jenosek/BP/measurements/spec5.png

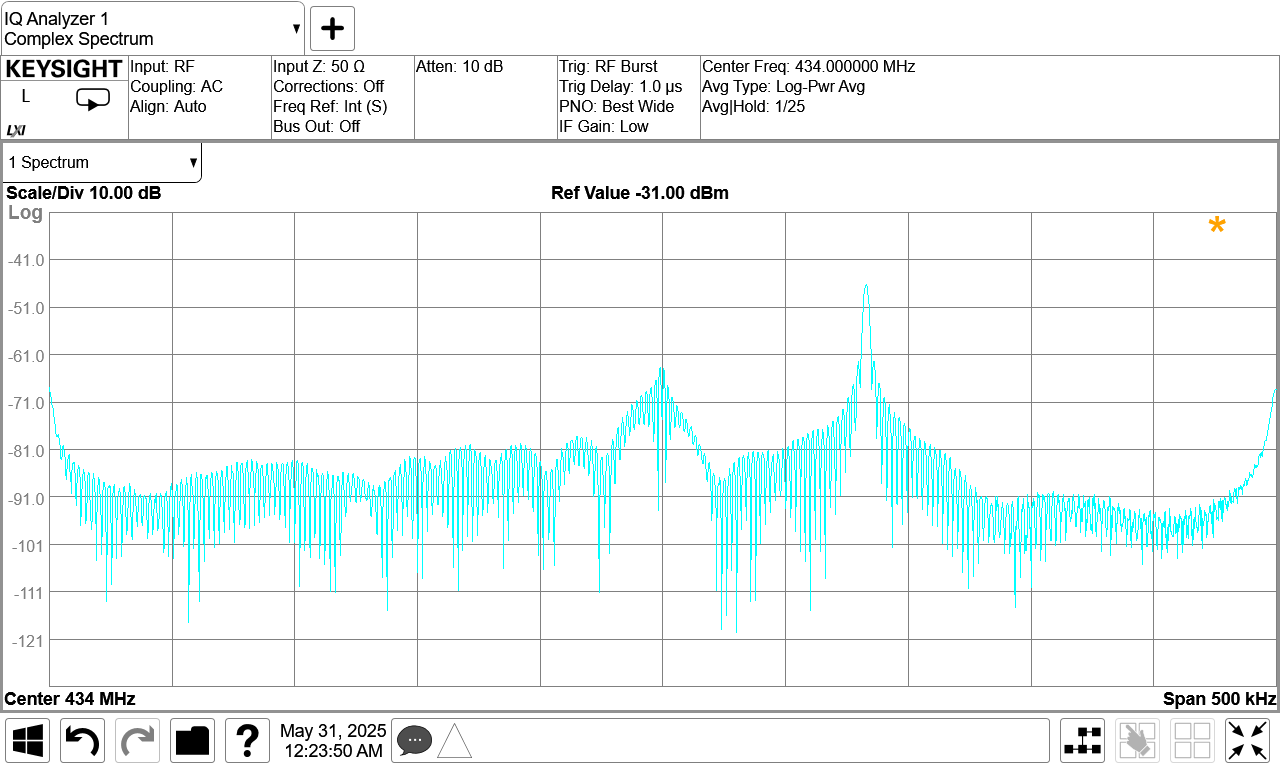
measurements/spec5.png
