jenosek/BP/measurements/spec25.png

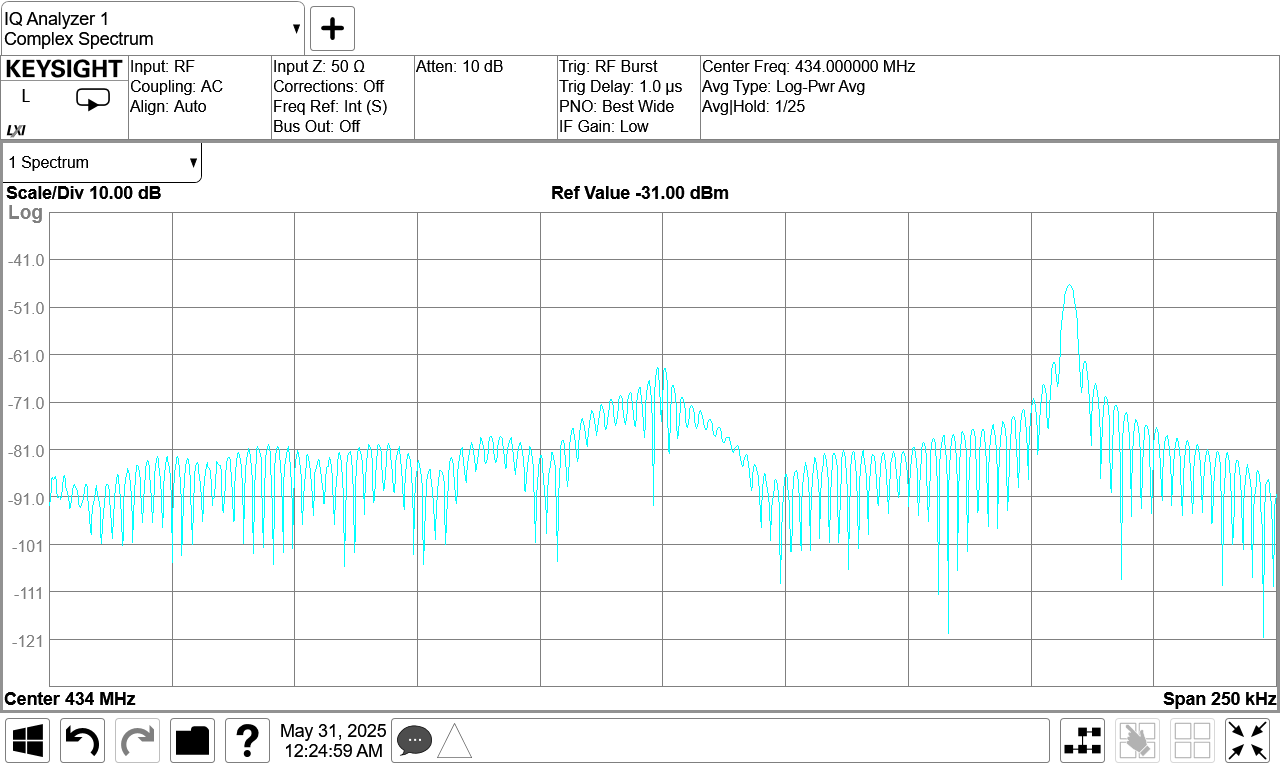
measurements/spec25.png
