jenosek/BP/measurements/specfm.png

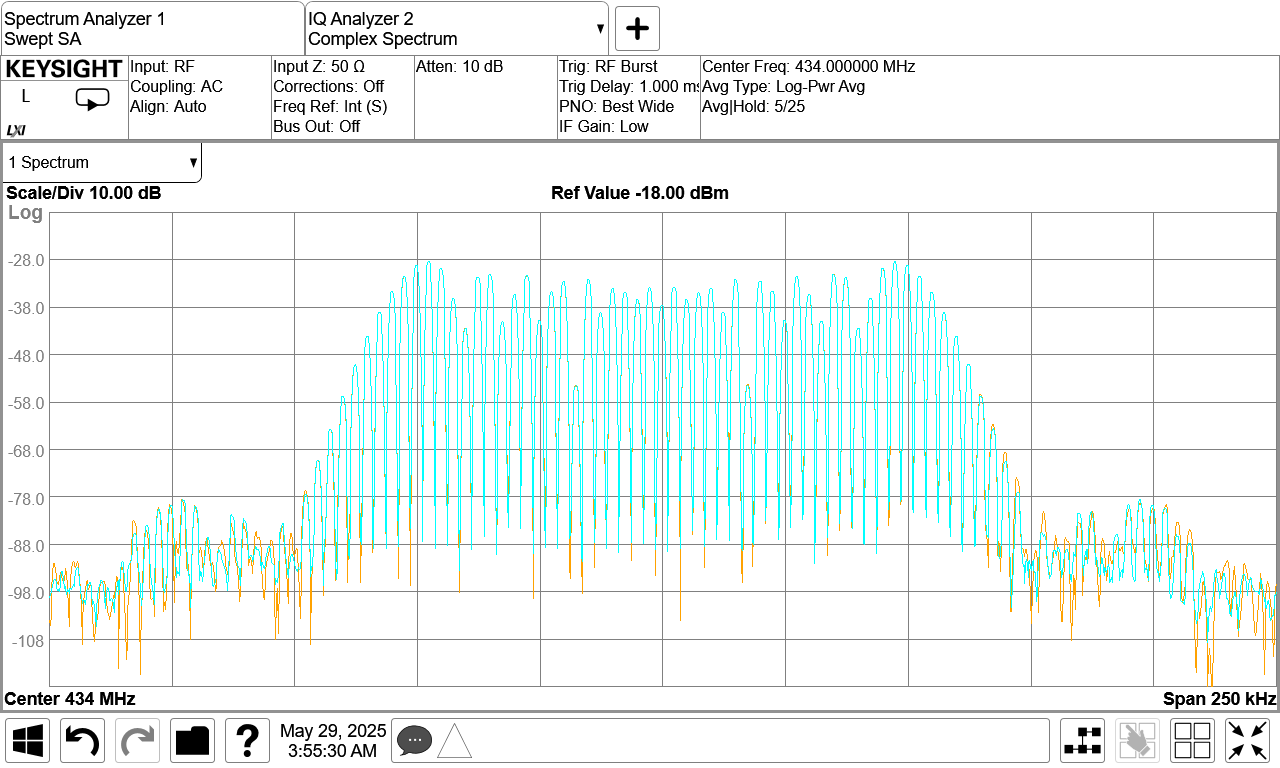
measurements/specfm.png
