jenosek/BP/measurements/ANT.PNG

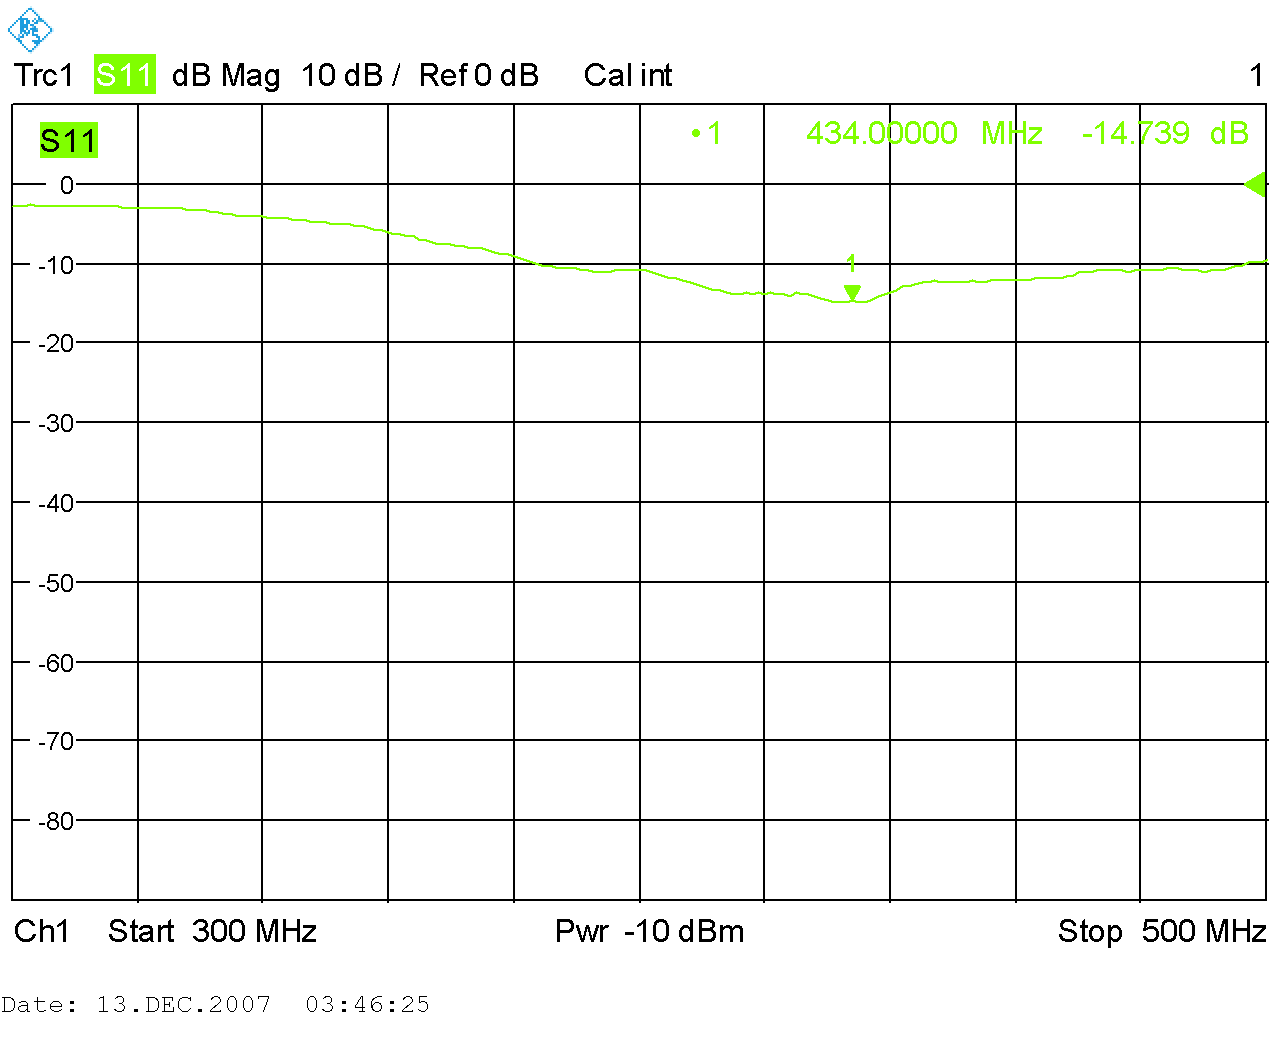
measurements/ANT.PNG
