jenosek/BP/measurements/zvlneni.png

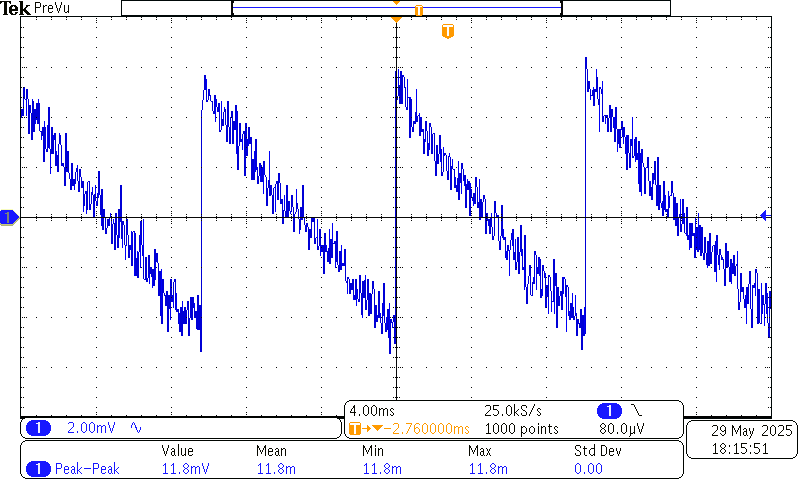
measurements/zvlneni.png
