jenosek/BP/hardware/PCBs/antenna/gerber/antenna-Edge_Cuts.pdf

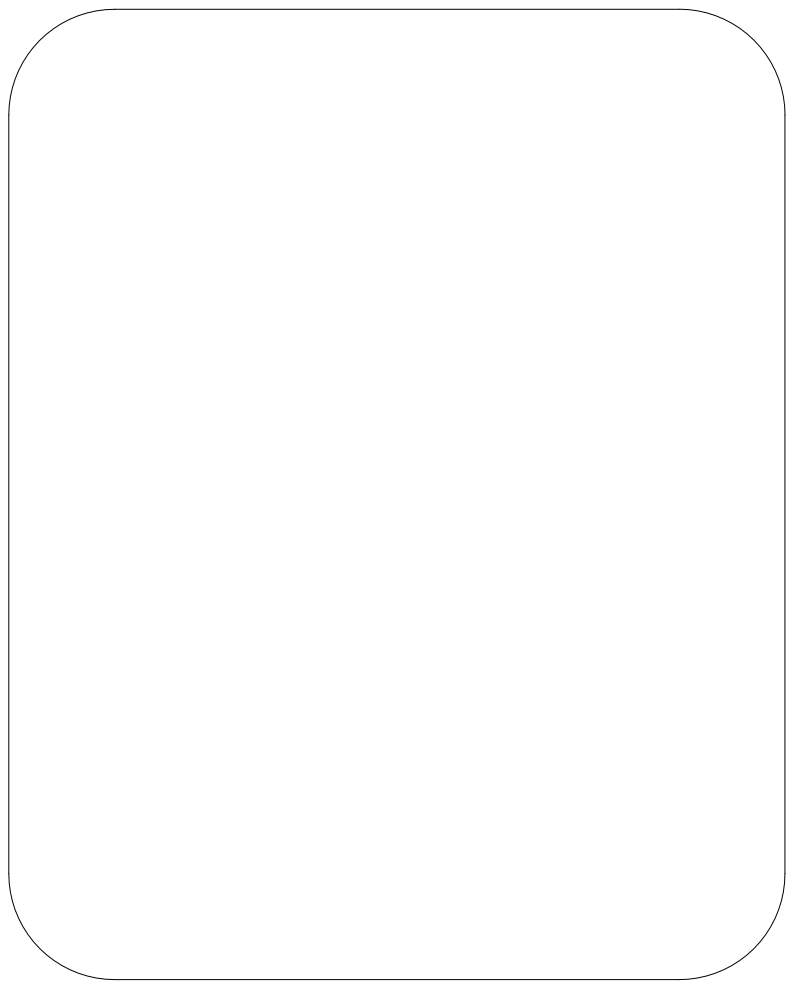
[picture p6: page 1]
