jenosek/BP/hardware/PCBs/antenna/gerber/antenna-F_Cu.pdf

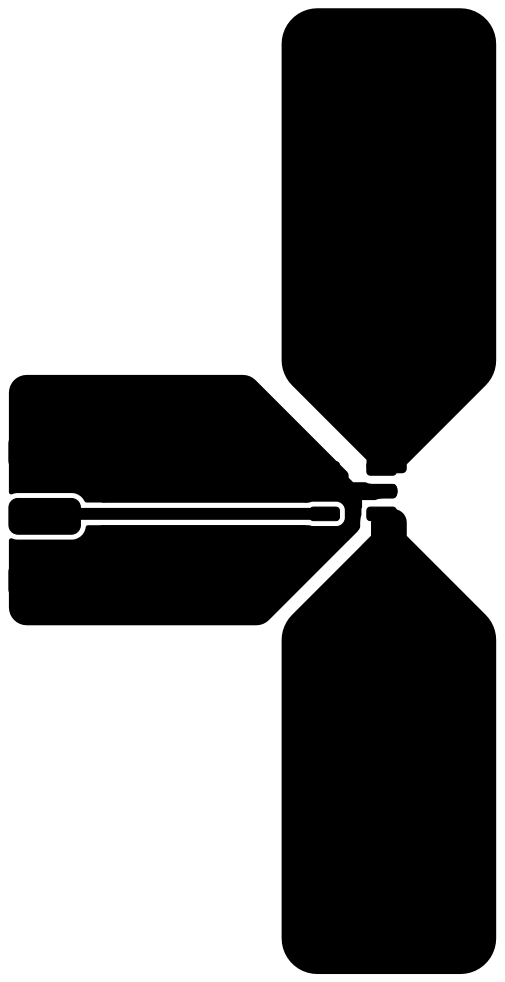
[picture p7: page 1]
