jenosek/BP/hardware/PCBs/antenna/gerber/antenna-F_Mask.pdf

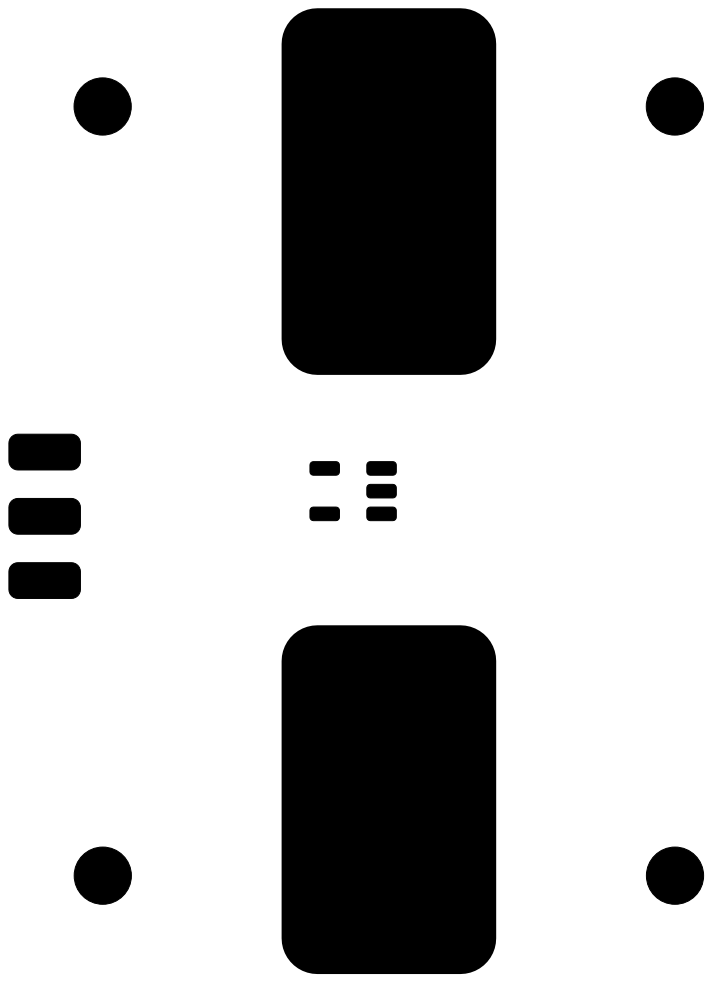
[picture p8: page 1]
