jenosek/BP/hardware/PCBs/antenna/gerber/antenna-F_Paste.pdf

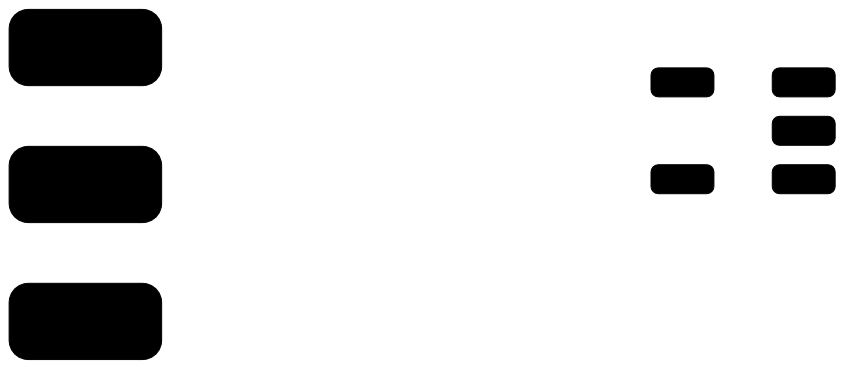
[picture p9: page 1]
