jenosek/BP/hardware/PCBs/antenna/gerber/antenna-F_Silkscreen.pdf

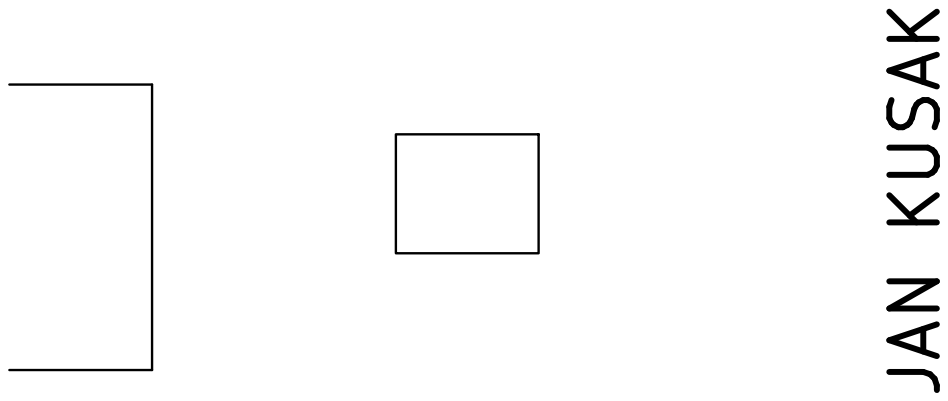
[picture p10: page 1]
