jenosek/BP/hardware/PCBs/antenna/gerber/pcb_Kusak.pdf

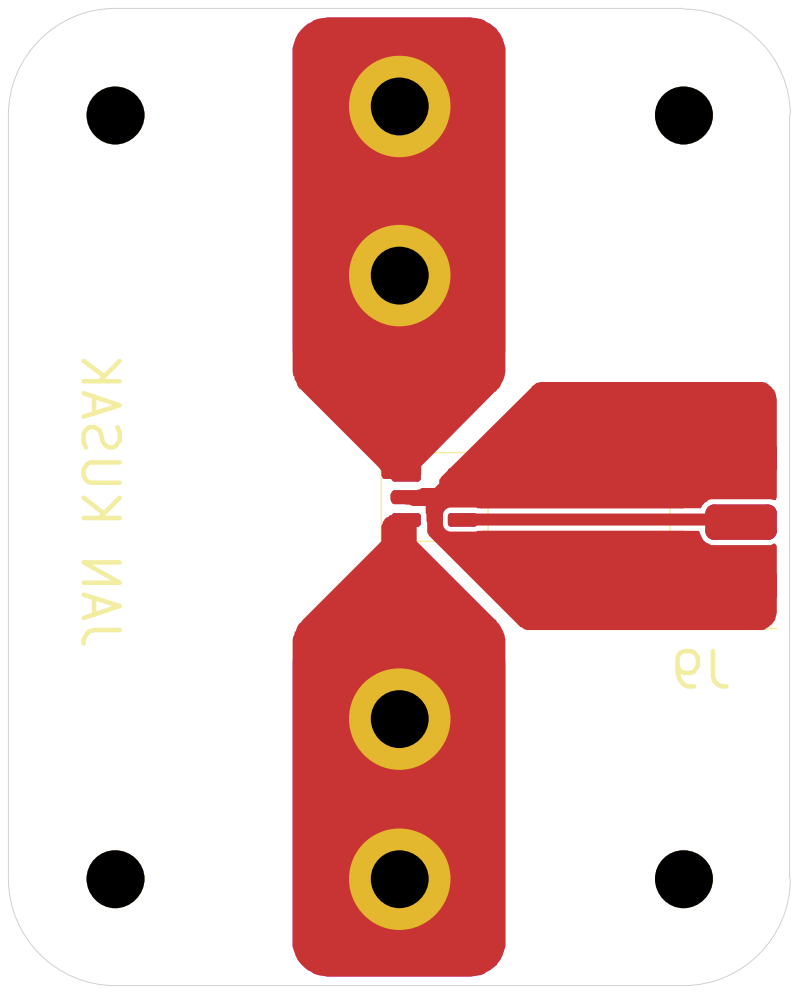
[picture p11: page 1]
