jenosek/BP/simulations/PSpice/tx_pa/tx_pa-PSpiceFiles/SCHEMATIC1/ac/ac.cir

** Profile: "SCHEMATIC1-ac"  [ C:\Skola\VUT\CubeSat\BP\simulations\PSpice\tx_pa\tx_pa-pspicefiles\schematic1\ac.sim ] 

** Creating circuit file "ac.cir" 
** WARNING: THIS AUTOMATICALLY GENERATED FILE MAY BE OVERWRITTEN BY SUBSEQUENT SIMULATIONS

*Libraries: 
* Profile Libraries :
* Local Libraries :
* From [PSPICE NETLIST] section of C:\Users\honza\AppData\Roaming\SPB_Data\cdssetup\OrCAD_PSpice\17.2.0\PSpice.ini file:
.lib "nomd.lib" 

*Analysis directives: 
.AC DEC 1400 100megHz 10GHz
.STEP LIN PARAM c 4pF 8pF 0.1pF 
.OPTIONS ADVCONV
.PROBE64 V(alias(*)) I(alias(*)) W(alias(*)) D(alias(*)) NOISE(alias(*)) 
.INC "..\SCHEMATIC1.net" 


.END
