jenosek/BP/simulations/PSpice/tx_pa/tx_pa-PSpiceFiles/SCHEMATIC1/test_cap/test_cap.cir

** Profile: "SCHEMATIC1-test_cap"  [ C:\Skola\VUT\CubeSat\BP\simulations\PSpice\tx_pa\tx_pa-pspicefiles\schematic1\test_cap.sim ] 

** Creating circuit file "test_cap.cir" 
** WARNING: THIS AUTOMATICALLY GENERATED FILE MAY BE OVERWRITTEN BY SUBSEQUENT SIMULATIONS

*Libraries: 
* Profile Libraries :
* Local Libraries :
* From [PSPICE NETLIST] section of C:\Users\honza\AppData\Roaming\SPB_Data\cdssetup\OrCAD_PSpice\17.2.0\PSpice.ini file:
.lib "nomd.lib" 

*Analysis directives: 
.AC DEC 1400 1megHz 10GHz
.OPTIONS ADVCONV
.PROBE64 V(alias(*)) I(alias(*)) W(alias(*)) D(alias(*)) NOISE(alias(*)) 
.INC "..\SCHEMATIC1.net" 


.END
