jenosek/BP/simulations/PSpice/ntc/ntc-PSpiceFiles/SCHEMATIC1/dc/dc.cir

** Profile: "SCHEMATIC1-dc"  [ c:\users\honza\desktop\bakalarka\sim\ntc\ntc-pspicefiles\schematic1\dc.sim ] 

** Creating circuit file "dc.cir" 
** WARNING: THIS AUTOMATICALLY GENERATED FILE MAY BE OVERWRITTEN BY SUBSEQUENT SIMULATIONS

*Libraries: 
* Profile Libraries :
* Local Libraries :
* From [PSPICE NETLIST] section of C:\Users\honza\AppData\Roaming\SPB_Data\cdssetup\OrCAD_PSpice\17.2.0\PSpice.ini file:
.lib "nomd.lib" 

*Analysis directives: 
.DC LIN PARAM T 273.15 323.15 1 
.OPTIONS ADVCONV
.PROBE64 V(alias(*)) I(alias(*)) W(alias(*)) D(alias(*)) NOISE(alias(*)) 
.INC "..\SCHEMATIC1.net" 


.END
