jenosek/BP/simulations/PSpice/ntc/ntc-PSpiceFiles/SCHEMATIC1/V_diff/V_diff.cir

** Profile: "SCHEMATIC1-V_diff"  [ c:\users\honza\desktop\bakalarka\sim\ntc\ntc-pspicefiles\schematic1\v_diff.sim ] 

** Creating circuit file "V_diff.cir" 
** WARNING: THIS AUTOMATICALLY GENERATED FILE MAY BE OVERWRITTEN BY SUBSEQUENT SIMULATIONS

*Libraries: 
* Profile Libraries :
* Local Libraries :
* From [PSPICE NETLIST] section of C:\Users\honza\AppData\Roaming\SPB_Data\cdssetup\OrCAD_PSpice\17.2.0\PSpice.ini file:
.lib "nomd.lib" 

*Analysis directives: 
.DC LIN PARAM T 298.15 318.15 1 
.STEP LIN PARAM R1 100 10k 100 
.OPTIONS ADVCONV
.PROBE64 V(alias(*)) I(alias(*)) W(alias(*)) D(alias(*)) NOISE(alias(*)) 
.INC "..\SCHEMATIC1.net" 


.END
