jenosek/BP/(list of files, drawings)

Other design files:
simulations/PSpice/lp_ant/LP_ANT.DSN
simulations/PSpice/lp_ant/lp_ant.opj
simulations/PSpice/ntc/NTC.DSN
simulations/PSpice/ntc/ntc.opj
simulations/PSpice/tx_pa/TX_PA.DSN
simulations/PSpice/tx_pa/tx_pa.opj
