jenosek/BP/hardware/PCBs/antenna/antenna.kicad_pcb

## KiCad design hardware/PCBs/antenna/antenna.kicad_pcb (2025-04-19)

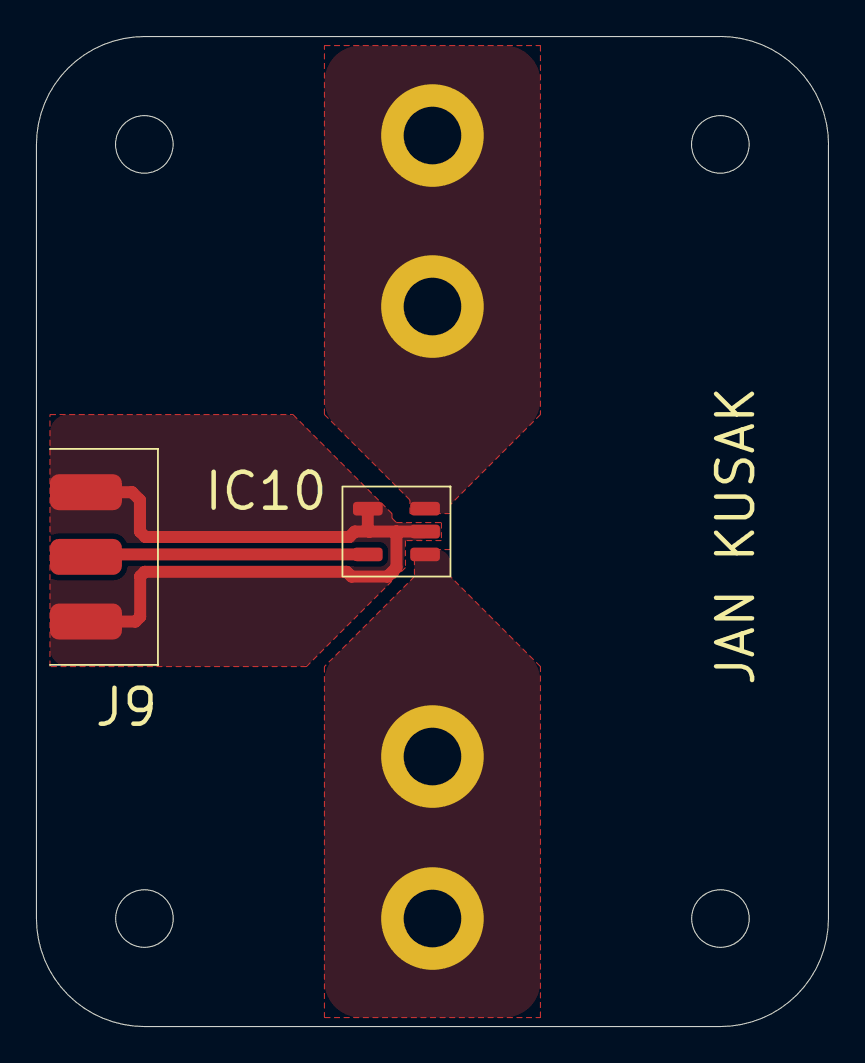
[picture p12: board antenna.kicad_pcb from above]

Board: 2 copper layers, 44.0 x 55.0 mm, 10 parts (0 on the bottom side), 4 nets.

Parts:
H, H5, H6, H8: MountingHole; MountingHole_3.2mm_M3
H1, H2, H3, H4: MountingHole_Pad; MountingHole_3.2mm_M3_ISO7380_Pad
IC10: C1.5-52T+
J9: sma_diagonal

Connections:
GND: IC10.2 (SECONDARY_CT), IC10.4 (PRIMARY), J9.1 (GND), J9.3 (GND)
unnamed: IC10.6 (PRIMARY_DOT), J9.2 (SIGNAL)
unnamed: H3.1, H4.1, IC10.3 (SECONDARY)
unnamed: H1.1, H2.1, IC10.1 (SECONDARY_DOT)
