jenosek/BP/hardware/PCBs/eps/eps.kicad_pcb

## KiCad design hardware/PCBs/eps/eps.kicad_pcb (2025-04-11)

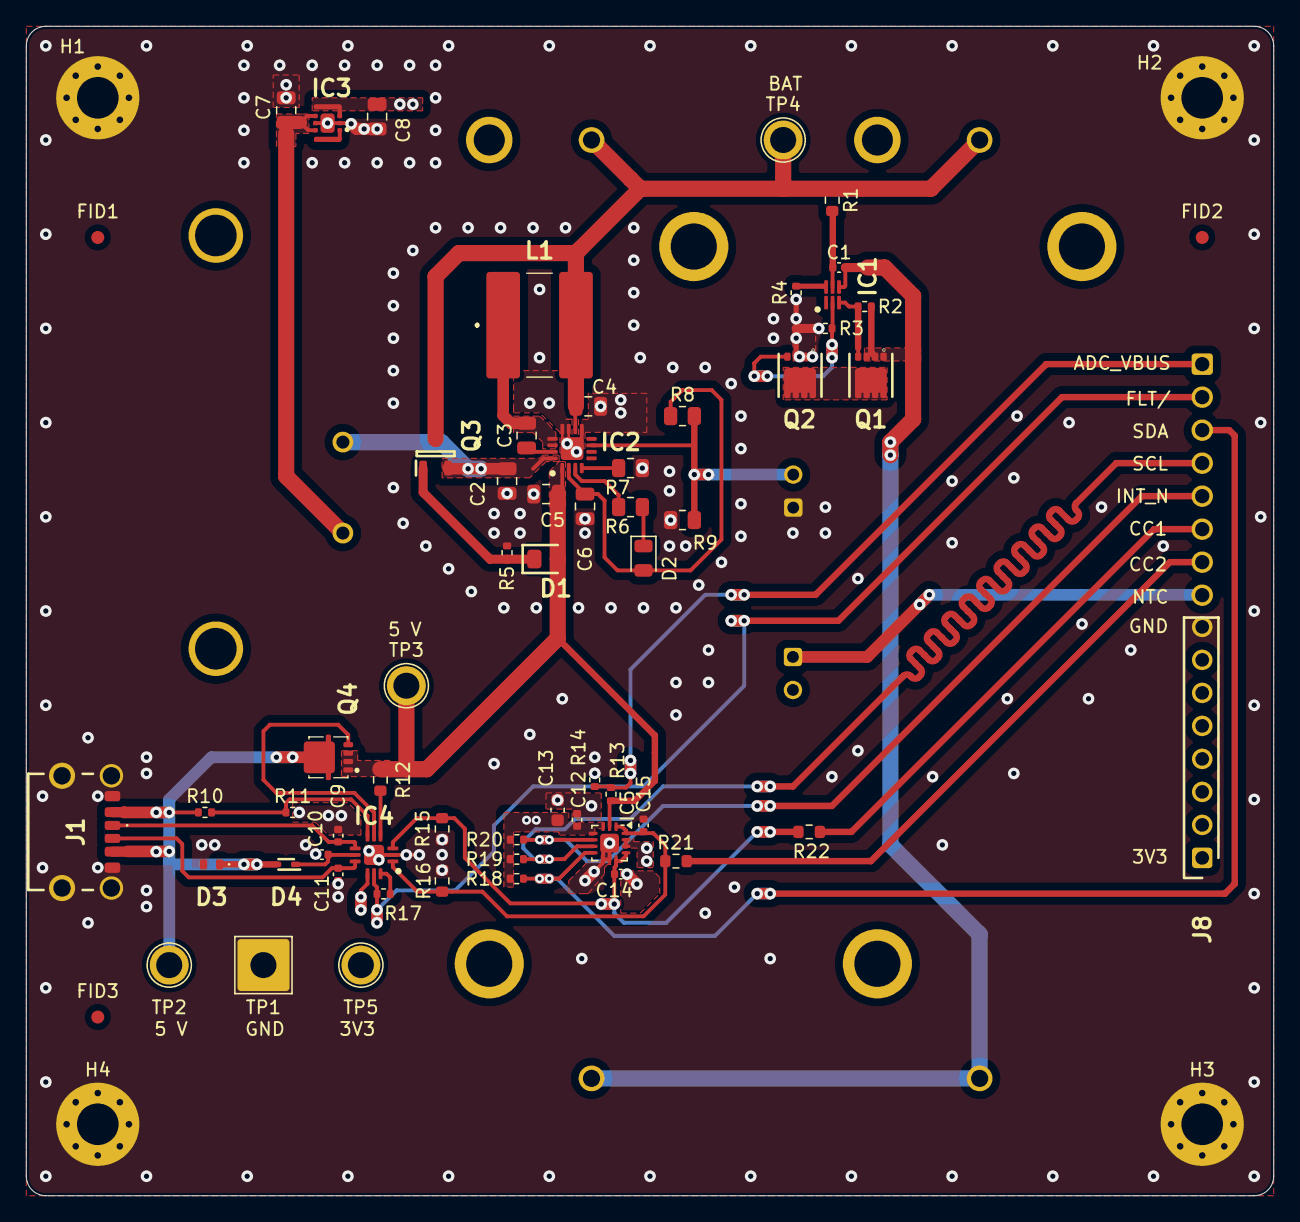
[picture p14: board eps.kicad_pcb from above]

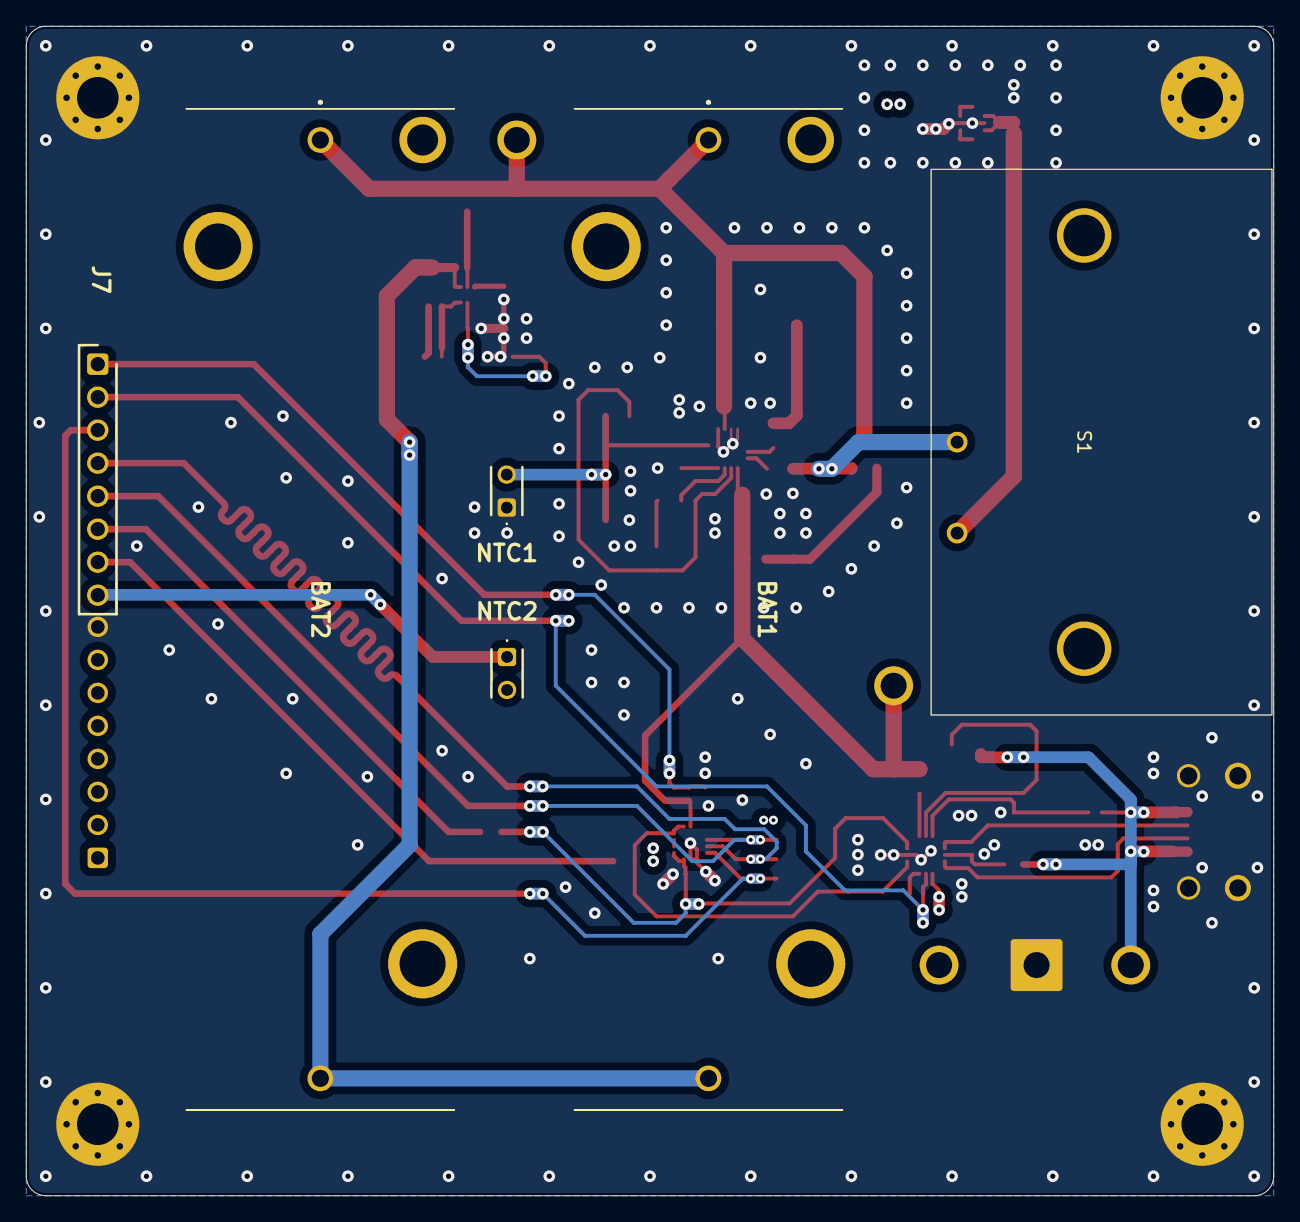
[picture p15: board eps.kicad_pcb from below]

Board: 4 copper layers, 96.0 x 90.0 mm, 71 parts (6 on the bottom side), 38 nets.

Parts:
BAT1, BAT2: 1043
C1, C10, C12: 100n; C_0402_1005Metric
C2, C4, C8: 10u; C_0805_2012Metric
C3: 47n; C_0805_2012Metric
C5, C6: 2u2; C_0805_2012Metric
C7: 4u7; C_0805_2012Metric
C9, C11, C14, C15: 330p; C_0402_1005Metric
C13: 1u; C_0603_1608Metric
D1: TS4148_RBG; DIOC2012X85N
D2: LED; LED_0805_2012Metric
D3: ESDA25P35-1U1M; ESDA25P351U1M
D4: BAT54KFILM; SODFL1608X70N
FID1, FID2, FID3: Fiducial; Fiducial_1mm_Mask2mm
H1, H2, H3, H4: MountingHole_Pad; MountingHole_3.2mm_M3_Pad_Via
IC1: BQ29732DSER; SON50P150X150X80-6N
IC2: BQ25302RTER; QFN50P300X300X80-17N-D
IC3: XCL240B333FR-G; XCL103D503CRG
IC4: TCPP01-M12; QFN50P300X300X100-13N-D
IC5: FUSB302BMPX; WQFN-14-1EP_2.5x2.5mm_P0.5mm_EP1.45x1.45mm
J1: UJC-H-G-SMT-2-P6-TR; UJCHGSMT2P6TR
J7: PH1-08-UA; HDRV8W64P0X254_1X8_2032X250X888P
J8: PRT-09279; RHDR8W87P0X254_1X8_2087X250X865P
L1: SRN8040-1R0Y; SRN80408R2Y
NTC1, NTC2: 103AT-2; 103AT2
Q1, Q2: CSD16406Q3; DQG_VSON-CLIP
Q3: DMP2305U-7; SOT96P240X115-3N
Q4: STL11N3LLH6; STL20N6F7
R1: 330; R_0603_1608Metric
R2, R3: 4M99; R_0402_1005Metric
R4: 2k2; R_0402_1005Metric
R5: 100k; R_0402_1005Metric
R6: 150; R_0805_2012Metric
R7: 20k; R_0805_2012Metric
R8: 4k53; R_0805_2012Metric
R9: 23k2; R_0805_2012Metric
R10, R17: 10k; R_0402_1005Metric
R11: 2k4; R_0402_1005Metric
R12, R21, R22: 0R; R_0603_1608Metric
R13: 1k69; R_0402_1005Metric
R14: 3k3; R_0402_1005Metric
R15, R16: 5k1; R_0603_1608Metric
R18, R19, R20: 4k7; R_0402_1005Metric
S1: RA12131100
TP1: TestPoint; TestPoint_THTPad_4.0x4.0mm_Drill2.0mm
TP2, TP3, TP4, TP5: TestPoint; TestPoint_Plated_Hole_D2.0mm

Connections:
+3V3: C8.1, C12.1, C13.1, IC3.3 (VOUT), IC3.8 (L2), IC4.10 (DB/), IC4.12 (VCC), IC5.3 (VDD), IC5.4 (VDD), IC5.12 (VCONN), IC5.13 (VCONN), J8.1, NTC2.2, R17.2, R18.1, R19.1, R20.1, TP5.1
/ADC_VBUS_PS: J7.1, R13.2, R14.1
/BYPASS_CC1_PS: J7.6, R22.2
/BYPASS_CC2_PS: J7.7, R21.2
/FLT/_PS: IC4.11 (FLT/), J7.2, R17.1
/INT_N_PS: IC5.5 (INT_N), J7.5, R20.2
/NTC_2_PS: J7.8, NTC2.1
/USB_CC1: C14.1, IC4.3 (CC1), IC5.10 (CC1), IC5.11 (CC1), R15.1, R22.1
/USB_CC2: C15.1, IC4.1 (CC2), IC5.1 (CC2), IC5.14 (CC2), R16.1, R21.1
/USB_SCL_PS: IC5.6 (SCL), J7.4, R19.2
/USB_SDA_PS: IC5.7 (SDA), J7.3, R18.2
/VBUS: C5.1, D1.2 (A), IC2.1 (VBUS), IC5.2 (VBUS), Q4.1 (S_1), Q4.2 (S_2), Q4.3 (S_3), R12.1, R13.1, TP3.1
GND: C2.2, C4.2, C5.2, C6.2, C7.2, C8.2, C9.1, C10.2, C11.2, C12.2, C13.2, C14.2, C15.2, D3.2 (A), H1.1, H2.1, H3.1, H4.1, IC2.9 (VSET), IC2.11 (GND_1), IC2.12 (GND_2), IC2.17 (EP), IC3.2 (AGND), IC3.5 (PGND), IC3.9 (EP), IC4.2 (GND), IC4.13 (EP), IC5.8 (GND), IC5.9 (GND), IC5.15 (GND), J1.1 (MH1), J1.2 (MH2), J1.3 (MH3), J1.4 (MH4), J1.A12 (GND_1), J1.B12 (GND_2), J8.8, NTC1.1, Q2.1 (S_1), Q2.2 (S_2), Q2.3 (S_3), R3.2, R4.2, R5.2, R7.2, R9.2, R11.2, R14.2, R15.2, R16.2, TP1.1
unnamed: BAT1.1 (+), BAT2.1 (+), C4.1, IC2.10 (BAT), L1.2, Q3.3 (D), R1.1, TP4.1
unnamed: BAT1.2 (-), BAT2.2 (-), C1.2, IC1.4 (VSS), Q1.1 (S_1), Q1.2 (S_2), Q1.3 (S_3), R2.2
unnamed: D1.1 (K), Q3.1 (G), R5.1
unnamed: C6.1, D2.2 (A), IC2.2 (REGN), R8.1
unnamed: D2.1 (K), R6.2
unnamed: D3.1 (K), D4.2 (A), J1.A9 (VBUS_1), J1.B9 (VBUS_2), Q4.5 (D), R10.1, TP2.1
unnamed: C10.1, D4.1 (K), IC4.8 (IN_GD)
unnamed: C1.1, IC1.5 (BAT), R1.2
unnamed: IC1.2 (COUT), Q2.4 (G), R3.1
unnamed: IC1.3 (DOUT), Q1.4 (G), R2.1
unnamed: IC1.6 (V-), R4.1
unnamed: C3.1, IC2.15 (BTST)
unnamed: IC2.4 (ICHG), R7.1
unnamed: C2.1, IC2.16 (PMID), Q3.2 (S), S1.1
unnamed: IC2.3 (STAT), R6.1
unnamed: C3.2, IC2.13 (SW_1), IC2.14 (SW_2), L1.1
unnamed: IC2.7 (TS), NTC1.2, R8.2, R9.1
unnamed: C7.1, IC3.4 (EN), IC3.6 (VIN), S1.2
unnamed: IC3.1 (LX), IC3.7 (L1)
unnamed: C9.2, IC4.7 (CC1C), J1.A5 (CC1)
unnamed: C11.1, IC4.9 (CC2C), J1.B5 (CC2)
unnamed: IC4.5 (GATE), Q4.4 (G)
unnamed: IC4.4 (SOURCE), R12.2
unnamed: IC4.6 (VBUS_CTRL), R10.2, R11.1
unnamed: Q1.5 (D_1), Q1.6 (D_2), Q1.7 (D_3), Q1.8 (D_4), Q1.9, Q2.5 (D_1), Q2.6 (D_2), Q2.7 (D_3), Q2.8 (D_4), Q2.9
