jenosek/BP/hardware/PCBs/mcu/mcu.kicad_pcb

## KiCad design hardware/PCBs/mcu/mcu.kicad_pcb (2025-04-11)

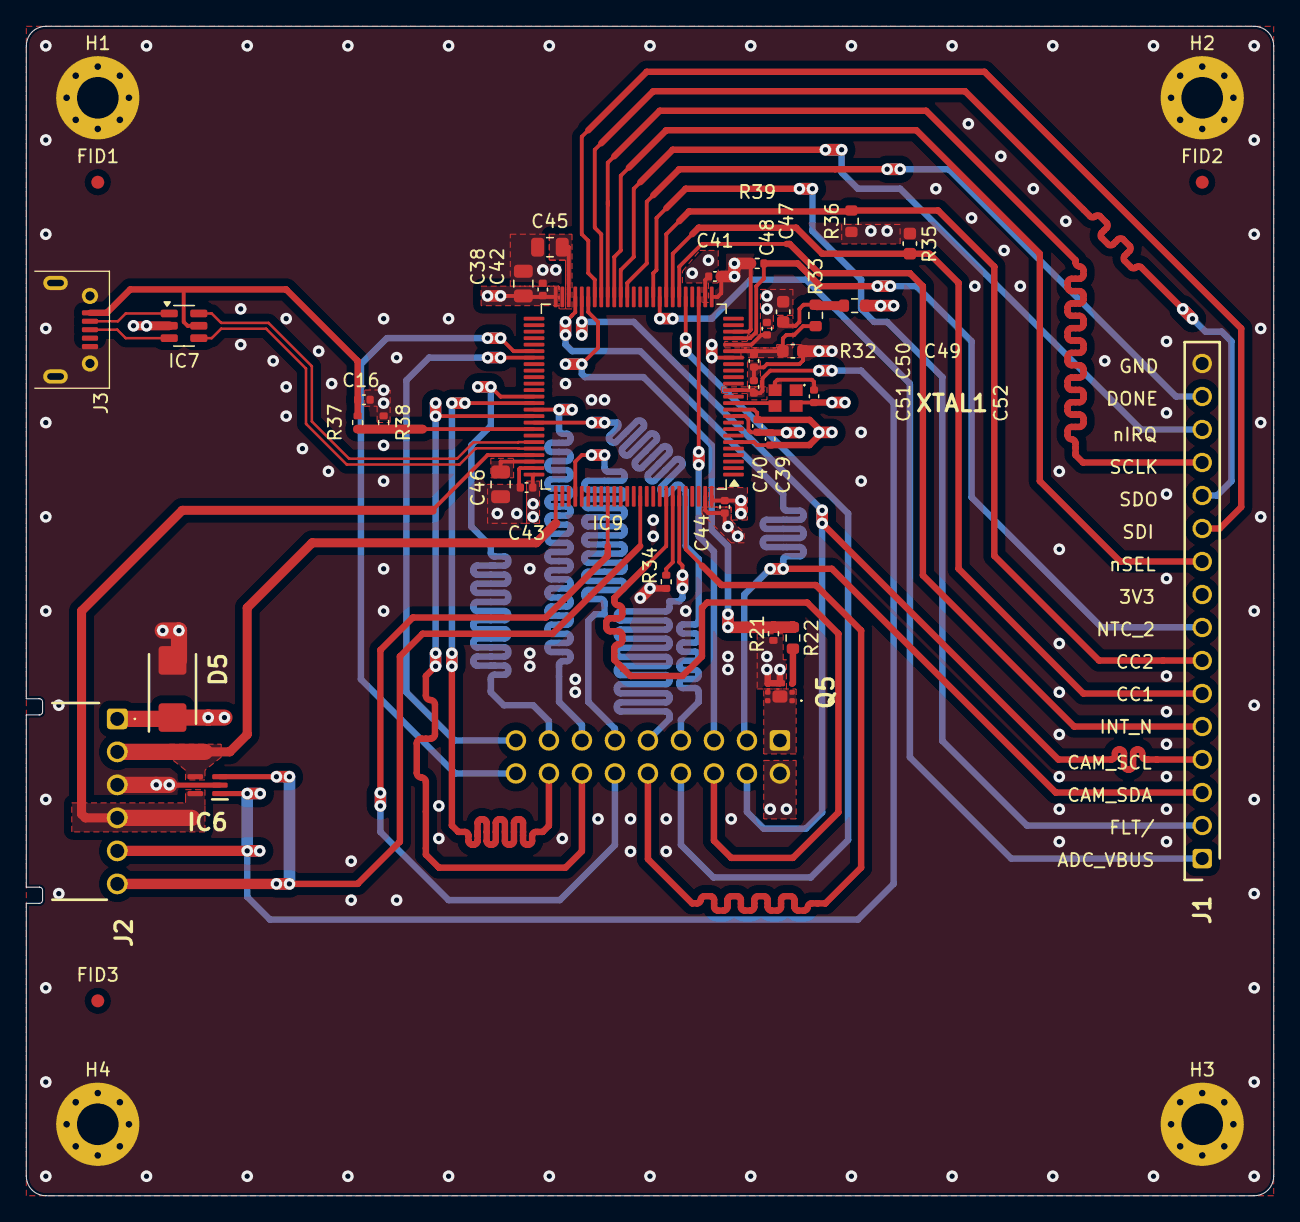
[picture p16: board mcu.kicad_pcb from above]

Board: 4 copper layers, 96.0 x 90.0 mm, 43 parts (1 on the bottom side), 49 nets.

Parts:
C16, C39, C40, C41, C42, C43, C44, C48, C50, C51: 100n; C_0402_1005Metric
C38: 4u7; C_0805_2012Metric
C45, C46: 2u2; C_0805_2012Metric
C47, C49: 1u; C_0603_1608Metric
C52: 10n; C_0402_1005Metric
D5: SMLVT3V3; DIOM5436X265N
FID1, FID2, FID3: Fiducial; Fiducial_1mm_Mask2mm
H1, H2, H3, H4: MountingHole_Pad; MountingHole_3.2mm_M3_Pad_Via
IC6: ESDALC6V1W5; SOT65P210X110-5N
IC7: USBLC6-2SC6; SOT-23-6
IC9: STM32H7A3VIT6; LQFP-100_14x14mm_P0.5mm
J1: 61301611821; RHDR16W82P0X254_1X16_4114X250X865P
J2: 22-16-2060; 22162060
J3: MCR-B-S-RA-SMT-CS5A-NF-TR
J4: RS2-18-G; RHDR18W60P254_2X9_2337X500X889P
Q5: DMN1008UFDF-7; DMN1008UFDF7
R21: 100k; R_0402_1005Metric
R22: 169; R_0603_1608Metric
R32, R33, R36: 0R; R_0603_1608Metric
R34, R39: 10k; R_0402_1005Metric
R35: 0R; C_0603_1608Metric
R37: 1k69; R_0402_1005Metric
R38: 3k3; R_0402_1005Metric
XTAL1: ASDDV-8.000MHZ-LR-T; AbraconASDDV

Connections:
+3V3: C38.1, C39.1, C40.1, C41.1, C42.1, C43.1, C44.1, C52.1, D5.1 (K), IC9.6 (VBAT), IC9.11 (VDD), IC9.27 (VDD), IC9.50 (VDD), IC9.75 (VDD), IC9.100 (VDD), J1.9, J2.1, J4.2, R32.1, XTAL1.4 (VDD)
/3V3: J4.1, Q5.1 (DRAIN_1), Q5.2 (DRAIN_2), Q5.5 (DRAIN_3), Q5.6 (DRAIN_4), Q5.7 (DRAIN_5)
/ADC_VBUS: IC9.34 (PB0), J1.1
/BOOT: IC9.94 (BOOT0), R34.2
/CAM_3V3: IC9.45 (PE15), R21.1, R22.1
/CAM_SCL: IC9.46 (PB10), J1.4, J4.4
/CAM_SDA: IC9.47 (PB11), J1.3, J4.3
/CC1: IC9.32 (PC4), J1.6, R35.1
/CC2: IC9.33 (PC5), J1.7, R36.1
/COMMAND_DONE: IC9.39 (PE9), J1.15
/D0: IC9.63 (PC6), J4.15
/D1: IC9.64 (PC7), J4.16
/D2: IC9.65 (PC8), J4.13
/D3: IC9.66 (PC9), J4.14
/D4: IC9.79 (PC11), J4.11
/D5: IC9.84 (PD3), J4.12
/D6: IC9.95 (PB8), J4.9
/D7: IC9.96 (PB9), J4.10
/FLT/: IC9.35 (PB1), J1.2
/HS: IC9.28 (PA4), J4.5
/INT_N: IC9.31 (PA7), J1.5
/MCLK: IC9.67 (PA8), J4.7
/NRST: C51.1, IC6.1 (I/01), IC9.14 (NRST), J2.5
/NTC_2+: IC9.22 (PA0), J1.8, R39.2
/PCLK: IC9.30 (PA6), J4.8
/PWDN: IC9.57 (PD10), J4.17
/RCC_OSC_IN: IC9.12 (PH0), XTAL1.3 (OUTPUT)
/RST: IC9.56 (PD9), J4.18
/SCLK: IC9.42 (PE12), J1.13
/SDI: IC9.44 (PE14), J1.11
/SDO: IC9.43 (PE13), J1.12
/SWCLK: IC6.4 (I/03), IC9.76 (PA14), J2.2
/SWDIO: IC6.5 (I/04), IC9.72 (PA13), J2.4
/TRACE: IC6.3 (I/02), IC9.89 (PB3), J2.6
/USB_OTG_HS_D+: IC7.4 (I/O2), IC9.71 (PA12)
/USB_OTG_HS_D-: IC7.6 (I/O1), IC9.70 (PA11)
/USB_OTG_HS_VBUS: C16.2, IC7.5 (VBUS), J3.1 (VBUS), R37.1
/USB_VBUS: IC9.68 (PA9), R37.2, R38.1
/VCAP1: C45.1, IC9.48 (VCAP)
/VCAP2: C46.1, IC9.73 (VCAP)
/VDDA: C47.1, C48.1, IC9.21 (VDDA), R32.2, R33.2
/VREF+: C49.1, C50.1, IC9.20 (VREF+), R33.1
/VS: IC9.93 (PB7), J4.6
/nIRQ: IC9.40 (PE10), J1.14
/nSEL: IC9.41 (PE11), J1.10
GND: C16.1, C38.2, C39.2, C40.2, C41.2, C42.2, C43.2, C44.2, C45.2, C46.2, C47.2, C48.2, C49.2, C50.2, C51.2, C52.2, D5.2 (A), H1.1, H2.1, H3.1, H4.1, IC6.2 (GND), IC7.2 (GND), IC9.10 (VSS), IC9.19 (VSSA), IC9.23 (PA1), IC9.26 (VSS), IC9.49 (VSS), IC9.74 (VSS), IC9.99 (VSS), J1.16, J2.3, J3.5 (GND), J3.6 (Shield), Q5.4 (SOURCE_1), Q5.8 (SOURCE_2), R21.2, R34.1, R35.2, R36.2, R38.2, R39.1, XTAL1.2 (GND)
unnamed: IC7.3 (I/O2), J3.3 (D+)
unnamed: IC7.1 (I/O1), J3.2 (D-)
unnamed: Q5.3 (GATE), R22.2
