jenosek/BP/hardware/schematics/Charger-PowerManagement.kicad_sch

## KiCad design hardware/schematics/Charger-PowerManagement.kicad_sch (2025-02-28)

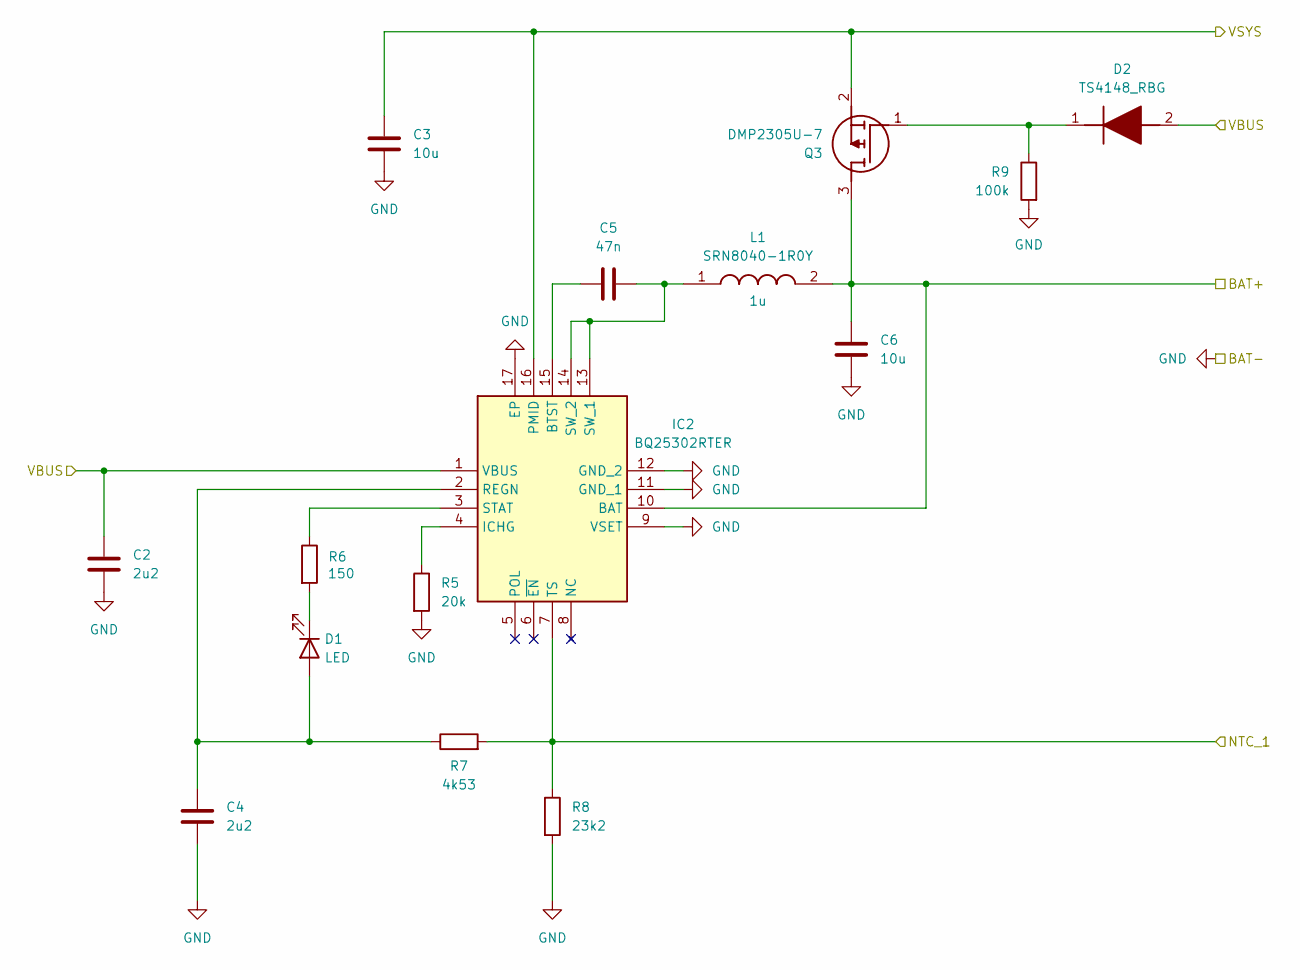
[picture p17: schematic Charger-PowerManagement.kicad_sch]

Parts:
C2, C4: 2u2; C_0805_2012Metric
C3, C6: 10u; C_0805_2012Metric
C5: 47n; C_0805_2012Metric
D1: LED; LED_0805_2012Metric
D2: TS4148_RBG; DIOC2012X85N; Manufacturer_Part_Number TS4148 RBG; Mouser Part Number 821-TS4148RBG
IC2: BQ25302RTER; QFN50P300X300X80-17N-D; Manufacturer_Part_Number BQ25302RTER; Mouser Part Number 595-BQ25302RTER
L1: SRN8040-1R0Y; SRN80408R2Y; Manufacturer_Part_Number SRN8040-1R0Y; Mouser Part Number 652-SRN8040-1R0Y
Q3: DMP2305U-7; SOT96P240X115-3N; Manufacturer_Part_Number DMP2305U-7; Mouser Part Number 621-DMP2305U-7
R5: 20k; R_0805_2012Metric
R6: 150; R_0805_2012Metric
R7: 4k53; R_0805_2012Metric
R8: 23k2; R_0805_2012Metric
R9: 100k

Connections:
BAT+: C6.1, IC2.10 (BAT), L1.2, Q3.3 (D)
GND: C2.2, C3.2, C4.2, C6.2, IC2.9 (VSET), IC2.11 (GND_1), IC2.12 (GND_2), IC2.17 (EP), R5.2, R8.2, R9.2
NTC_1: IC2.7 (TS), R7.2, R8.1
unnamed: C4.1, D1.2 (A), IC2.2 (REGN), R7.1
unnamed: C5.1, IC2.15 (BTST)
unnamed: C5.2, IC2.13 (SW_1), IC2.14 (SW_2), L1.1
unnamed: D1.1 (K), R6.2
unnamed: D2.1 (K), Q3.1 (G), R9.1
unnamed: IC2.3 (STAT), R6.1
unnamed: IC2.4 (ICHG), R5.1
VBUS: C2.1, D2.2 (A), IC2.1 (VBUS)
VSYS: C3.1, IC2.16 (PMID), Q3.2 (S)
