jenosek/BP/hardware/schematics/Power_Management.kicad_sch

## KiCad design hardware/schematics/Power_Management.kicad_sch (2025-03-09)

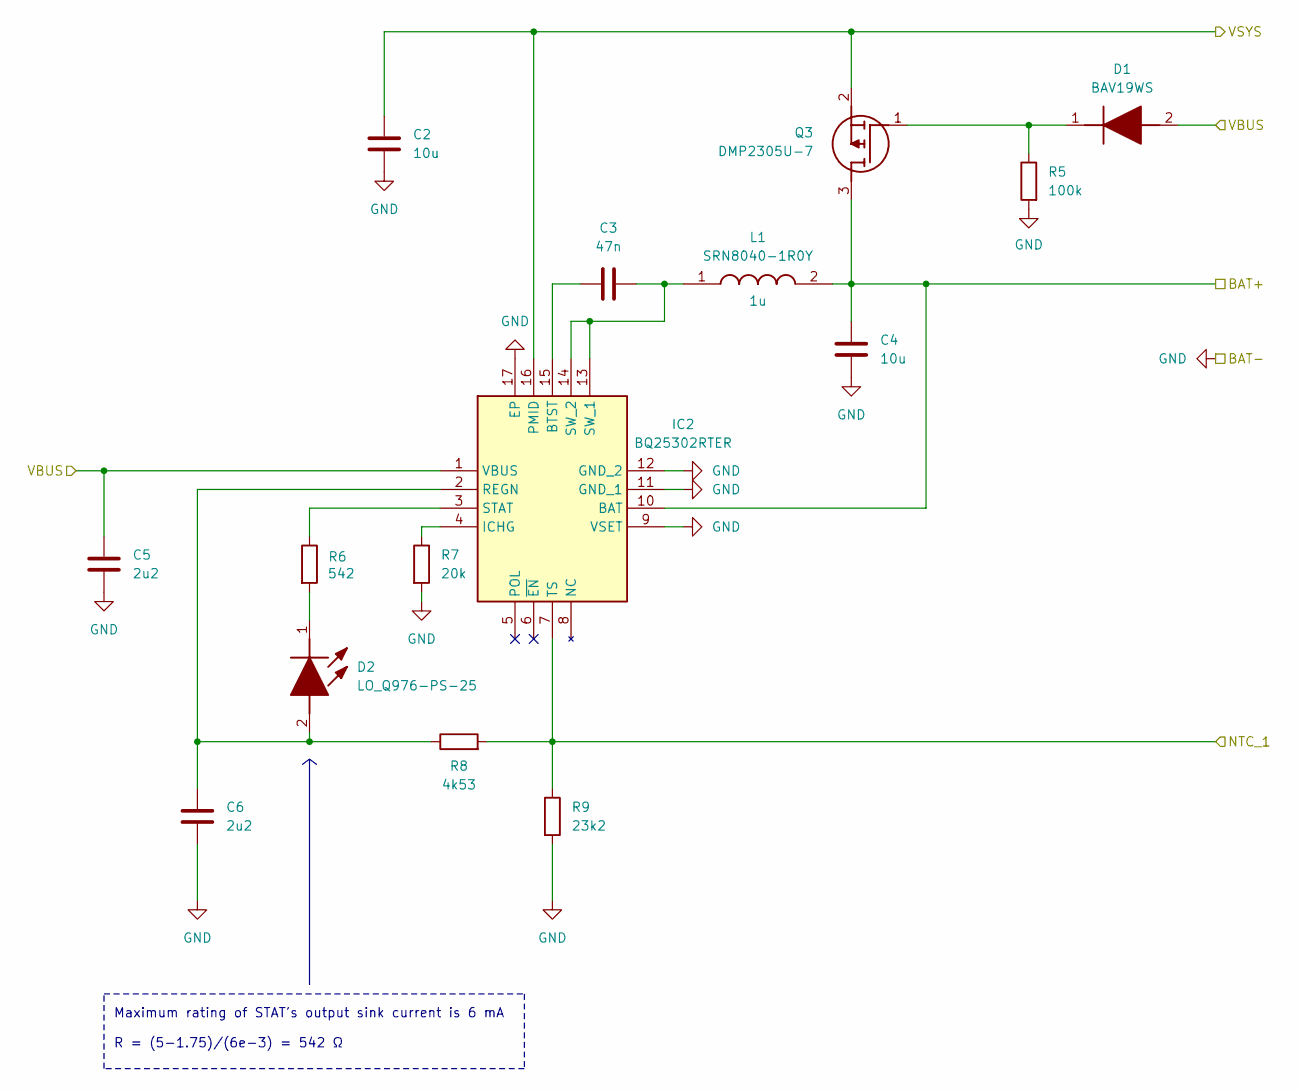
[picture p18: schematic Power_Management.kicad_sch]

Parts:
C2, C4: 10u; C_0805_2012Metric
C3: 47n; C_0402_1005Metric
C5, C6: 2u2; C_0805_2012Metric
D1: BAV19WS; D_SOD-323; Manufacturer_Part_Number BAV19WS
D2: LO_Q976-PS-25; LEDC1608X80N; Manufacturer_Part_Number LO Q976-PS-25; Mouser Part Number 720-LOQ976-PS-25
IC2: BQ25302RTER; QFN50P300X300X80-17N-D; Manufacturer_Part_Number BQ25302RTER; Mouser Part Number 595-BQ25302RTER
L1: SRN8040-1R0Y; SRN80408R2Y; Manufacturer_Part_Number SRN8040-1R0Y; Mouser Part Number 652-SRN8040-1R0Y
Q3: DMP2305U-7; SOT96P240X115-3N; Manufacturer_Part_Number DMP2305U-7; Mouser Part Number 621-DMP2305U-7
R5: 100k
R6: 542; R_0603_1608Metric
R7: 20k; R_0402_1005Metric
R8: 4k53; R_0805_2012Metric
R9: 23k2; R_0805_2012Metric

Connections:
BAT+: C4.1, IC2.10 (BAT), L1.2, Q3.3 (D)
GND: C2.2, C4.2, C5.2, C6.2, IC2.9 (VSET), IC2.11 (GND_1), IC2.12 (GND_2), IC2.17 (EP), R5.2, R7.2, R9.2
NTC_1: IC2.7 (TS), R8.2, R9.1
unnamed: C3.1, IC2.15 (BTST)
unnamed: C3.2, IC2.13 (SW_1), IC2.14 (SW_2), L1.1
unnamed: C6.1, D2.2 (A), IC2.2 (REGN), R8.1
unnamed: D1.1 (K), Q3.1 (G), R5.1
unnamed: D2.1 (K), R6.2
unnamed: IC2.3 (STAT), R6.1
unnamed: IC2.4 (ICHG), R7.1
VBUS: C5.1, D1.2 (A), IC2.1 (VBUS)
VSYS: C2.1, IC2.16 (PMID), Q3.2 (S)

Notes on the sheet:
Maximum rating of STAT's output sink current is 6 mA R = (5-1.75)/(6e-3) = 542 Ω
