jenosek/BP/hardware/schematics/battery.kicad_sch

## KiCad design hardware/schematics/battery.kicad_sch (2025-03-07)

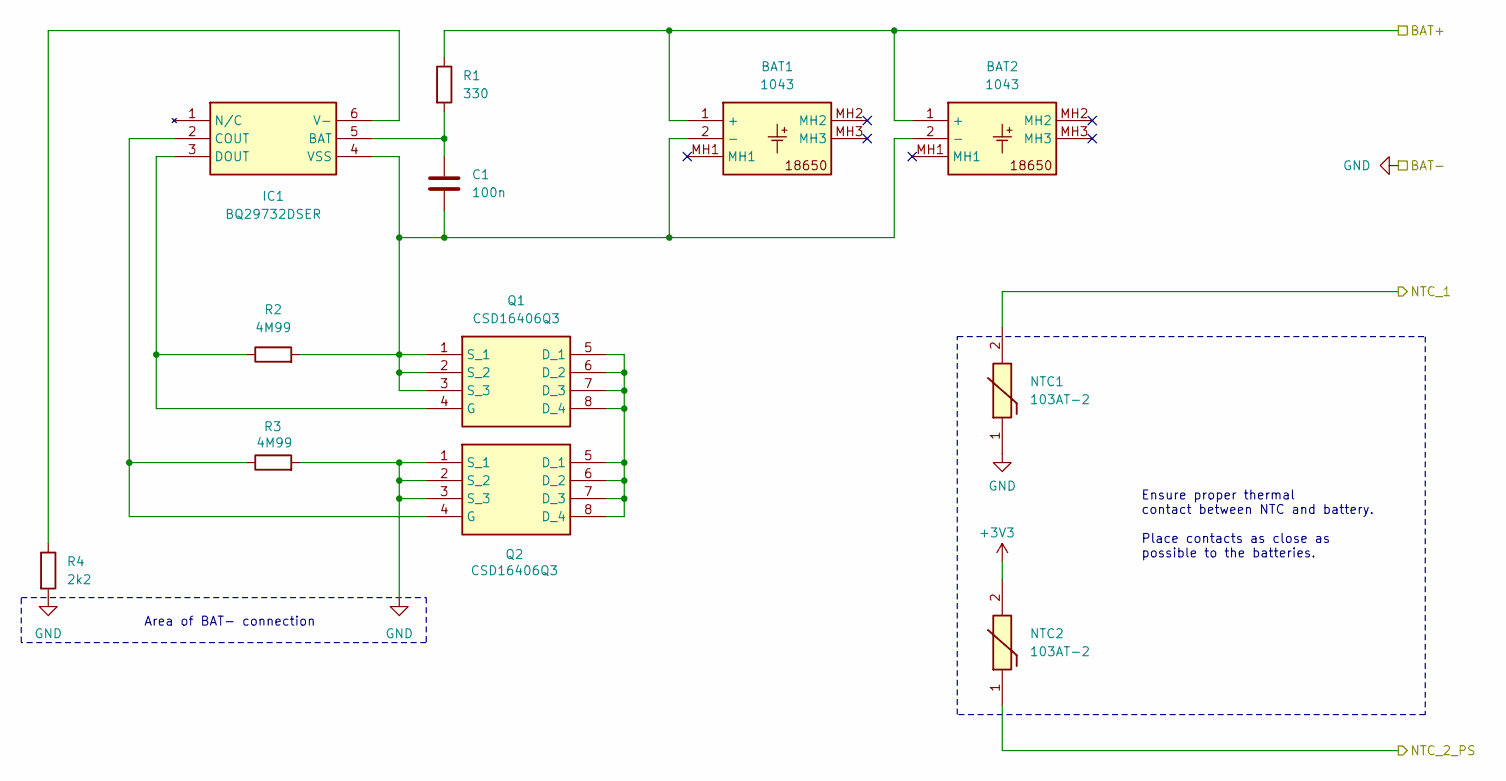
[picture p19: schematic battery.kicad_sch]

Parts:
BAT1, BAT2: 1043; Manufacturer_Part_Number 1043; Mouser Part Number 534-1043
C1: 100n; C_0402_1005Metric
IC1: BQ29732DSER; SON50P150X150X80-6N; Manufacturer_Part_Number BQ29732DSER; Mouser Part Number 595-BQ29732DSER
NTC1, NTC2: 103AT-2; 103AT2; Manufacturer_Part_Number 103AT-2; Mouser Part Number 954-103AT-2
Q1, Q2: CSD16406Q3; DQG_VSON-CLIP; Manufacturer_Part_Number CSD16406Q3; Mouser Part Number 595-CSD16406Q3
R1: 330; R_0603_1608Metric
R2, R3: 4M99; R_0402_1005Metric
R4: 2k2; R_0402_1005Metric

Connections:
+3V3: NTC2.2
BAT+: BAT1.1 (+), BAT2.1 (+), R1.1
GND: NTC1.1, Q2.1 (S_1), Q2.2 (S_2), Q2.3 (S_3), R3.2, R4.2
NTC_1: NTC1.2
NTC_2_PS: NTC2.1
unnamed: BAT1.2 (-), BAT2.2 (-), C1.2, IC1.4 (VSS), Q1.1 (S_1), Q1.2 (S_2), Q1.3 (S_3), R2.2
unnamed: C1.1, IC1.5 (BAT), R1.2
unnamed: IC1.2 (COUT), Q2.4 (G), R3.1
unnamed: IC1.3 (DOUT), Q1.4 (G), R2.1
unnamed: IC1.6 (V-), R4.1
unnamed: Q1.5 (D_1), Q1.6 (D_2), Q1.7 (D_3), Q1.8 (D_4), Q2.5 (D_1), Q2.6 (D_2), Q2.7 (D_3), Q2.8 (D_4)

Notes on the sheet:
Ensure proper thermal contact between NTC and battery. Place contacts as close as possible to the batteries.
Area of BAT- connection
