jenosek/BP/hardware/schematics/board_connector.kicad_sch

## KiCad design hardware/schematics/board_connector.kicad_sch (2025-03-07)

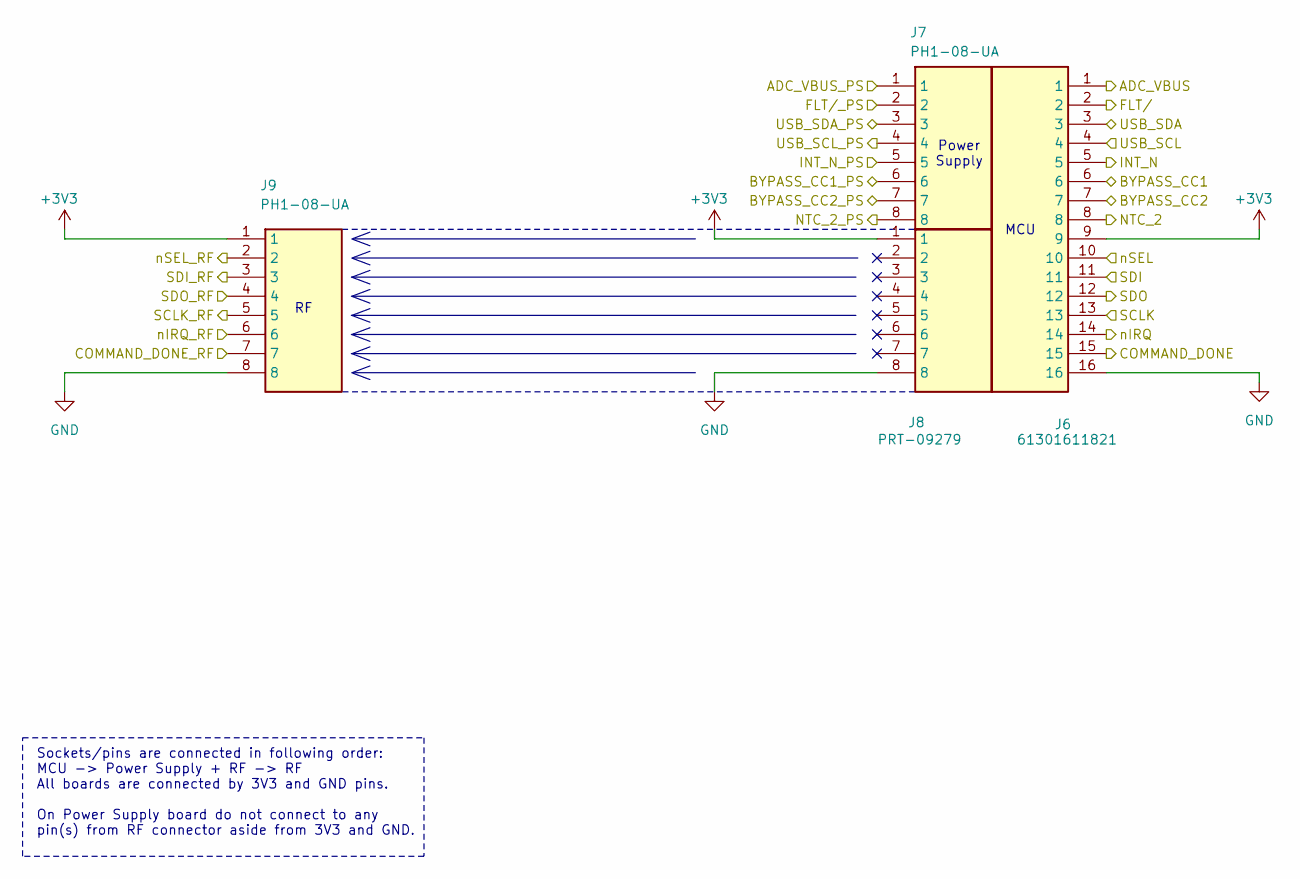
[picture p20: schematic board_connector.kicad_sch]

Parts:
J6: 61301611821; RHDR16W82P0X254_1X16_4114X250X865P; Manufacturer_Part_Number 61301611821; Mouser Part Number 710-61301611821
J7, J9: PH1-08-UA; HDRV8W64P0X254_1X8_2032X250X888P; Manufacturer_Part_Number PH1-08-UA; Mouser Part Number 737-PH1-08-UA
J8: PRT-09279; RHDR8W87P0X254_1X8_2087X250X865P; Manufacturer_Part_Number PRT-09279; Mouser Part Number 474-PRT-09279

Connections:
+3V3: J6.9, J8.1, J9.1
ADC_VBUS: J6.1
ADC_VBUS_PS: J7.1
BYPASS_CC1: J6.6
BYPASS_CC1_PS: J7.6
BYPASS_CC2: J6.7
BYPASS_CC2_PS: J7.7
COMMAND_DONE: J6.15
COMMAND_DONE_RF: J9.7
FLT/: J6.2
FLT/_PS: J7.2
GND: J6.16, J8.8, J9.8
INT_N: J6.5
INT_N_PS: J7.5
NTC_2: J6.8
NTC_2_PS: J7.8
SCLK: J6.13
SCLK_RF: J9.5
SDI: J6.11
SDI_RF: J9.3
SDO: J6.12
SDO_RF: J9.4
USB_SCL: J6.4
USB_SCL_PS: J7.4
USB_SDA: J6.3
USB_SDA_PS: J7.3
nIRQ: J6.14
nIRQ_RF: J9.6
nSEL: J6.10
nSEL_RF: J9.2

Notes on the sheet:
MCU
Power Supply
Sockets/pins are connected in following order: MCU -> Power Supply + RF -> RF All boards are connected by 3V3 and GND pins. On Power Supply board do not connect to any pin(s) from RF connector aside from 3V3 and GND.
