jenosek/BP/hardware/schematics/camera.kicad_sch

## KiCad design hardware/schematics/camera.kicad_sch (2025-03-06)

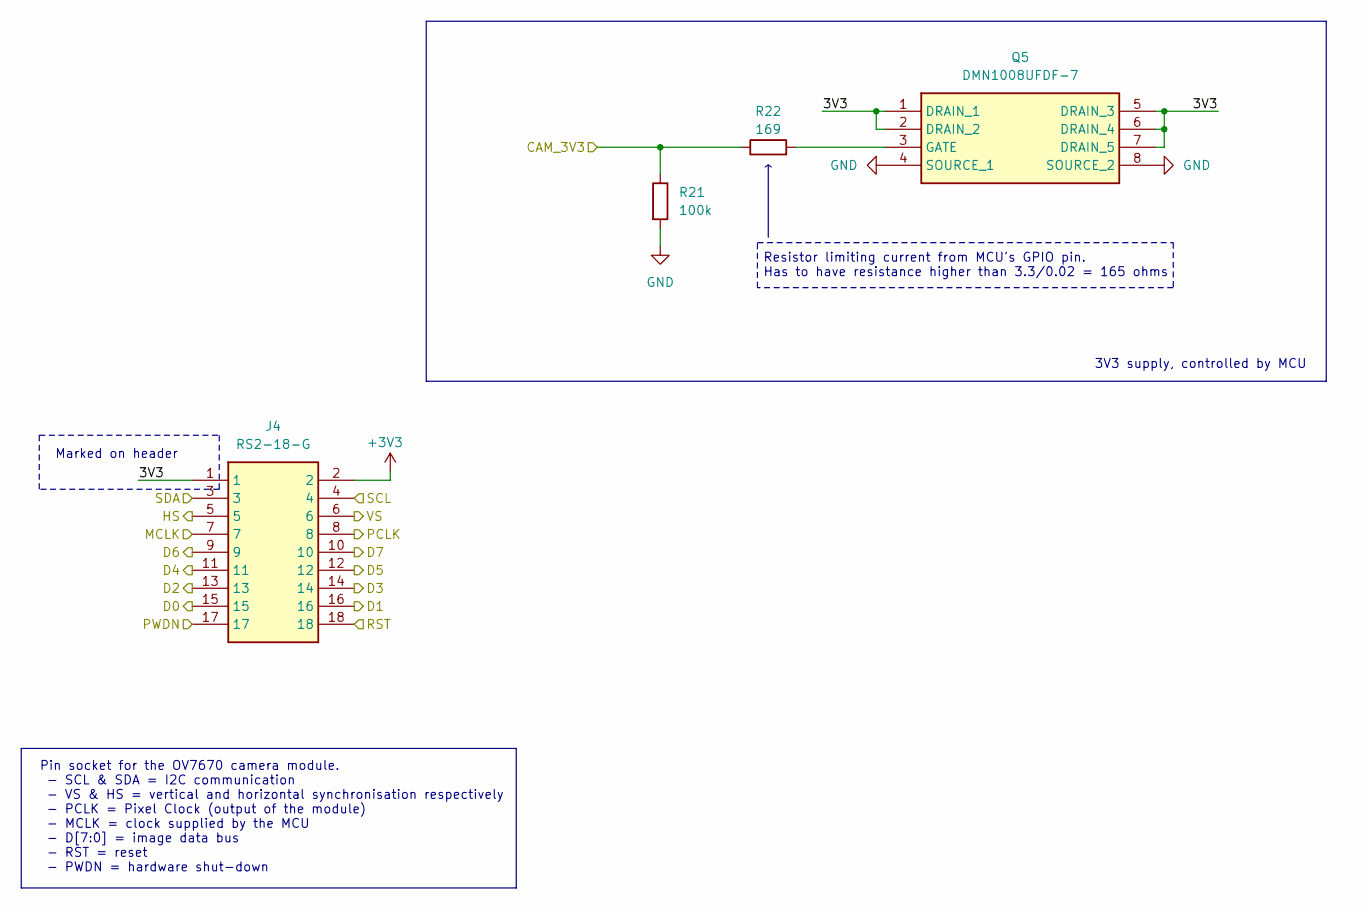
[picture p21: schematic camera.kicad_sch]

Parts:
J4: RS2-18-G; RHDR18W60P254_2X9_2337X500X889P; Manufacturer_Part_Number RS2-18-G
Q5: DMN1008UFDF-7; DMN1008UFDF7; Manufacturer_Part_Number DMN1008UFDF-7; Mouser Part Number 621-DMN1008UFDF-7
R21: 100k; R_0402_1005Metric
R22: 169; R_0603_1608Metric

Connections:
3V3: J4.1, Q5.1 (DRAIN_1), Q5.2 (DRAIN_2), Q5.5 (DRAIN_3), Q5.6 (DRAIN_4), Q5.7 (DRAIN_5)
+3V3: J4.2
CAM_3V3: R21.1, R22.1
D0: J4.15
D1: J4.16
D2: J4.13
D3: J4.14
D4: J4.11
D5: J4.12
D6: J4.9
D7: J4.10
GND: Q5.4 (SOURCE_1), Q5.8 (SOURCE_2), R21.2
HS: J4.5
MCLK: J4.7
unnamed: Q5.3 (GATE), R22.2
PCLK: J4.8
PWDN: J4.17
RST: J4.18
SCL: J4.4
SDA: J4.3
VS: J4.6

Notes on the sheet:
Pin socket for the OV7670 camera module. - SCL & SDA = I2C communication - VS & HS = vertical and horizontal synchronisation respectively - PCLK = Pixel Clock (output of the module) - MCLK = clock supplied by the MCU - D[7:0] = image data bus - RST = reset - PWDN = hardware shut-down
3V3 supply, controlled by MCU
Marked on header
Resistor limiting current from MCU's GPIO pin. Has to have resistance higher than 3.3/0.02 = 165 ohms
