jenosek/BP/hardware/schematics/dc_dc.kicad_sch

## KiCad design hardware/schematics/dc_dc.kicad_sch (2025-03-06)

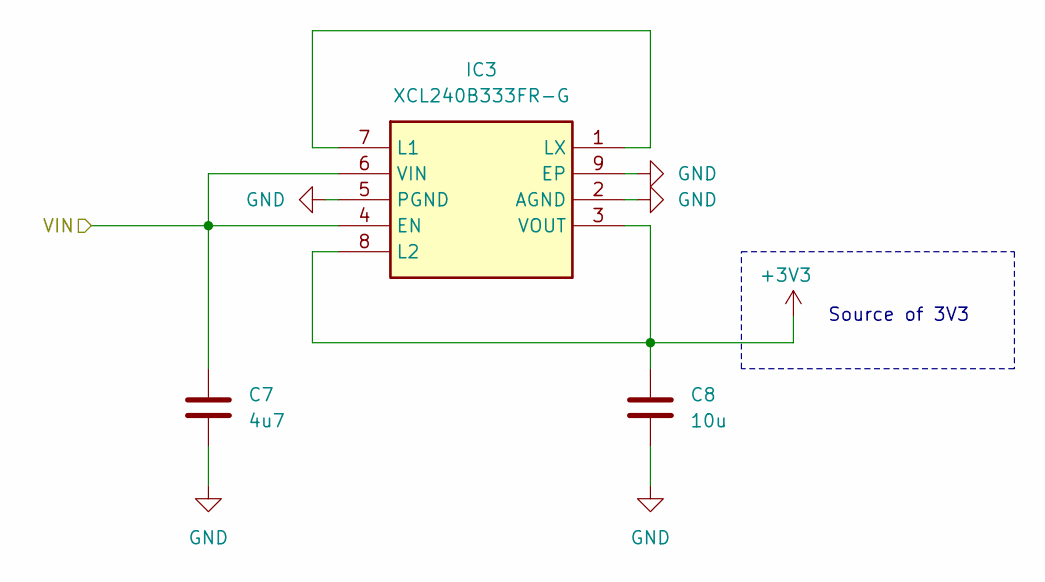
[picture p22: schematic dc_dc.kicad_sch]

Parts:
C7: 4u7; C_0805_2012Metric
C8: 10u; C_0805_2012Metric
IC3: XCL240B333FR-G; XCL103D503CRG; Manufacturer_Part_Number XCL240B333FR-G

Connections:
+3V3: C8.1, IC3.3 (VOUT), IC3.8 (L2)
GND: C7.2, C8.2, IC3.2 (AGND), IC3.5 (PGND), IC3.9 (EP)
unnamed: IC3.1 (LX), IC3.7 (L1)
VIN: C7.1, IC3.4 (EN), IC3.6 (VIN)

Notes on the sheet:
Source of 3V3
