jenosek/BP/hardware/schematics/mcu.kicad_sch

## KiCad design hardware/schematics/mcu.kicad_sch (2025-03-09)

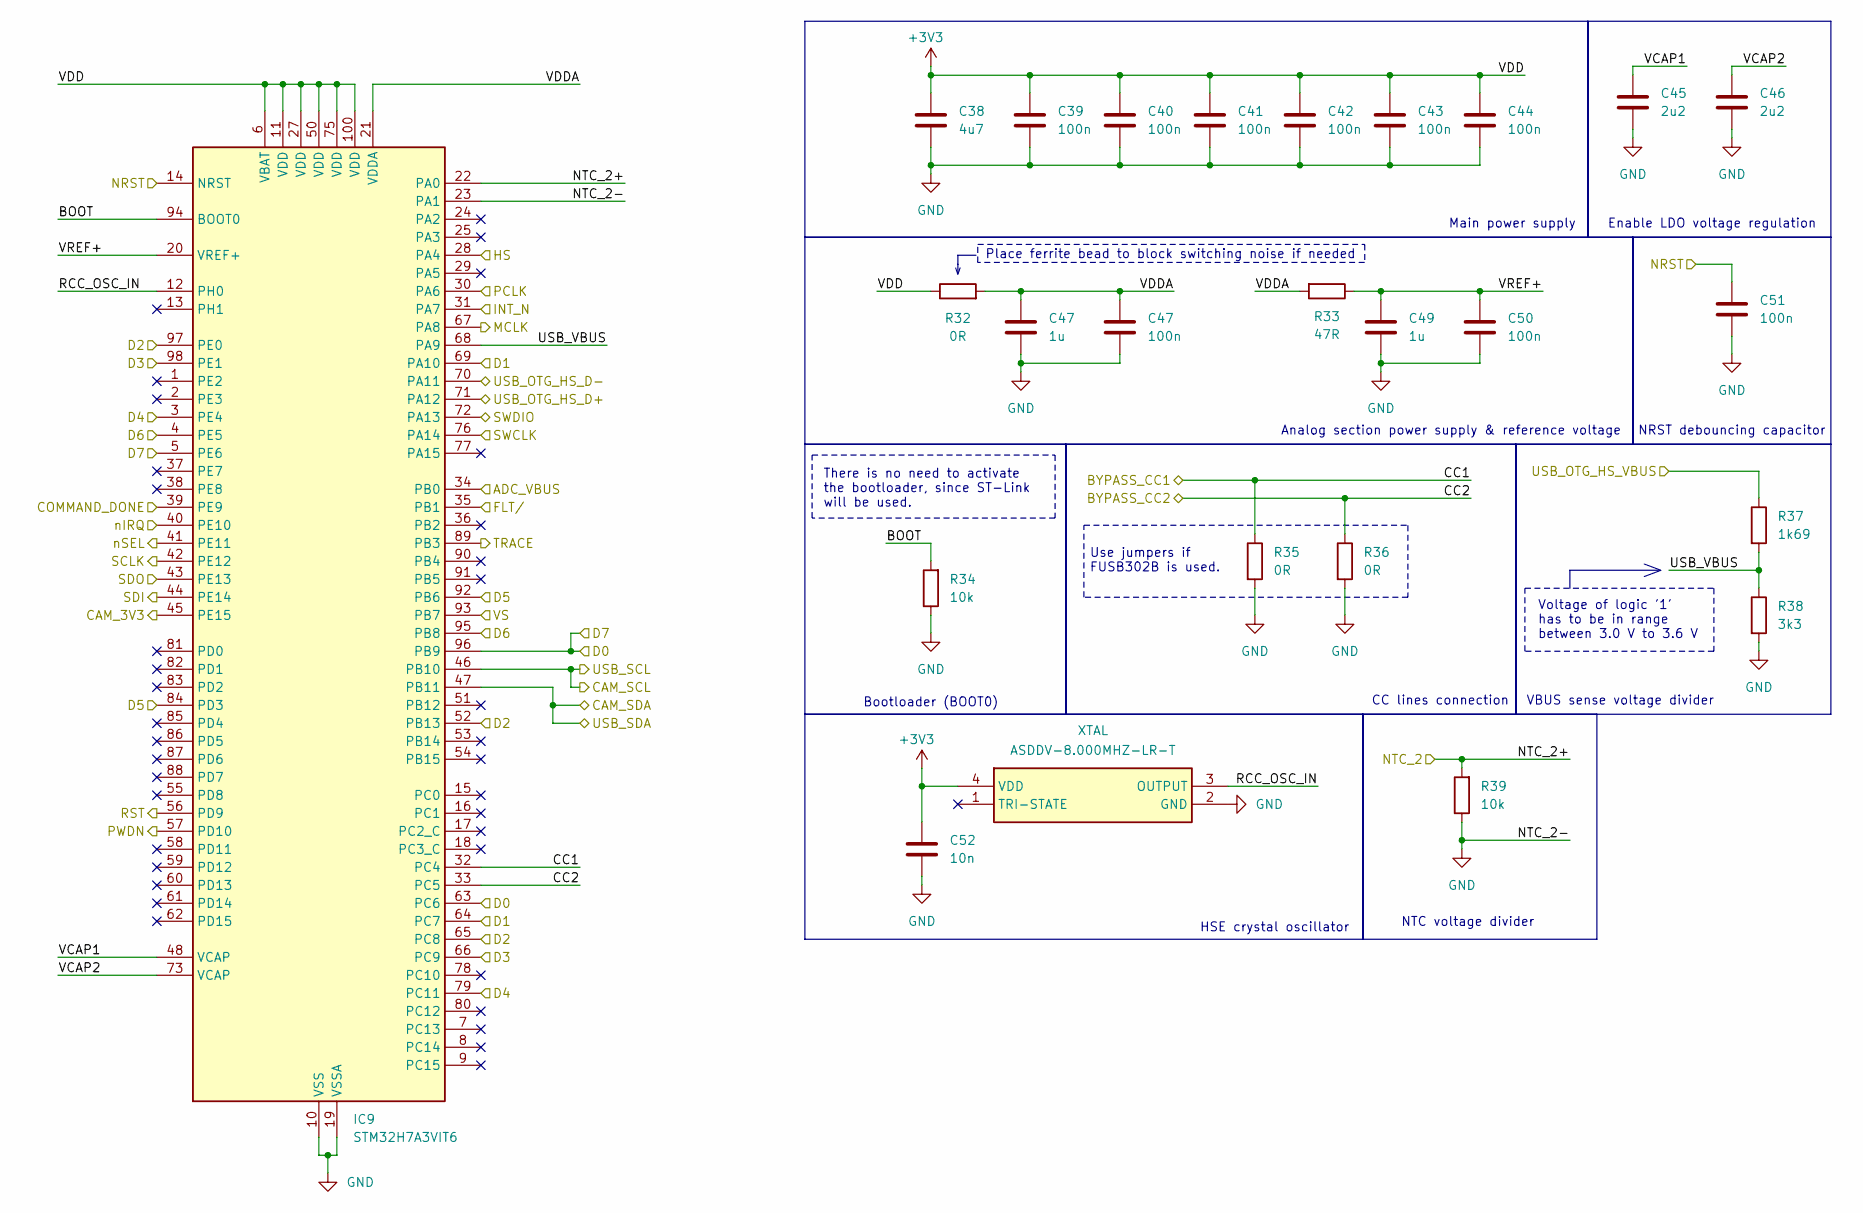
[picture p23: schematic mcu.kicad_sch]

Parts:
C38: 4u7; C_0805_2012Metric
C39, C40, C41, C42, C43, C44, C50, C51: 100n; C_0402_1005Metric
C45, C46: 2u2; C_0805_2012Metric
C47, C49: 1u; C_0603_1608Metric
C52: 10n; C_0402_1005Metric
IC9: STM32H7A3VIT6; LQFP-100_14x14mm_P0.5mm
R32, R36: 0R; R_0603_1608Metric
R33: 47R; R_0603_1608Metric
R34, R39: 10k; R_0402_1005Metric
R35: 0R; C_0603_1608Metric
R37: 1k69; R_0402_1005Metric
R38: 3k3; R_0402_1005Metric
XTAL: ASDDV-8.000MHZ-LR-T; AbraconASDDV; Manufacturer_Part_Number ASDDV-8.000MHZ-LR-T; Mouser Part Number 815-ASDDV-800MHZLRT

Connections:
+3V3: C38.1, C39.1, C40.1, C41.1, C42.1, C43.1, C44.1, C52.1, IC9.6 (VBAT), IC9.11 (VDD), IC9.27 (VDD), IC9.50 (VDD), IC9.75 (VDD), IC9.100 (VDD), R32.1, XTAL.4 (VDD)
ADC_VBUS: IC9.34 (PB0)
BOOT: IC9.94 (BOOT0), R34.2
BYPASS_CC1: IC9.32 (PC4), R35.1
BYPASS_CC2: IC9.33 (PC5), R36.1
CAM_3V3: IC9.45 (PE15)
CAM_SCL: IC9.46 (PB10)
CAM_SDA: IC9.47 (PB11)
COMMAND_DONE: IC9.39 (PE9)
D0: IC9.5 (PE6), IC9.63 (PC6), IC9.96 (PB9)
D1: IC9.64 (PC7), IC9.69 (PA10)
D2: IC9.52 (PB13), IC9.65 (PC8), IC9.97 (PE0)
D3: IC9.66 (PC9), IC9.98 (PE1)
D4: IC9.3 (PE4), IC9.79 (PC11)
D5: IC9.84 (PD3), IC9.92 (PB6)
D6: IC9.4 (PE5), IC9.95 (PB8)
FLT/: IC9.35 (PB1)
GND: C38.2, C39.2, C40.2, C41.2, C42.2, C43.2, C44.2, C45.2, C46.2, C47.2, C49.2, C50.2, C51.2, C52.2, IC9.10 (VSS), IC9.19 (VSSA), IC9.23 (PA1), IC9.26 (VSS), IC9.49 (VSS), IC9.74 (VSS), IC9.99 (VSS), R34.1, R35.2, R36.2, R38.2, R39.1, XTAL.2 (GND)
HS: IC9.28 (PA4)
INT_N: IC9.31 (PA7)
MCLK: IC9.67 (PA8)
NRST: C51.1, IC9.14 (NRST)
NTC_2: IC9.22 (PA0), R39.2
PCLK: IC9.30 (PA6)
PWDN: IC9.57 (PD10)
RCC_OSC_IN: IC9.12 (PH0), XTAL.3 (OUTPUT)
RST: IC9.56 (PD9)
SCLK: IC9.42 (PE12)
SDI: IC9.44 (PE14)
SDO: IC9.43 (PE13)
SWCLK: IC9.76 (PA14)
SWDIO: IC9.72 (PA13)
TRACE: IC9.89 (PB3)
USB_OTG_HS_D+: IC9.71 (PA12)
USB_OTG_HS_D-: IC9.70 (PA11)
USB_OTG_HS_VBUS: R37.1
USB_VBUS: IC9.68 (PA9), R37.2, R38.1
VCAP1: C45.1, IC9.48 (VCAP)
VCAP2: C46.1, IC9.73 (VCAP)
VDDA: C47.1, IC9.21 (VDDA), R32.2, R33.2
VREF+: C49.1, C50.1, IC9.20 (VREF+), R33.1
VS: IC9.93 (PB7)
nIRQ: IC9.40 (PE10)
nSEL: IC9.41 (PE11)

Notes on the sheet:
CC lines connection
HSE crystal oscillator
NTC voltage divider
Enable LDO voltage regulation
NRST debouncing capacitor
VBUS sense voltage divider
Voltage of logic '1' has to be in range between 3.0 V to 3.6 V
Analog section power supply & reference voltage
There is no need to activate the bootloader, since ST-Link will be used.
Use jumpers if FUSB302B is used.
Place ferrite bead to block switching noise if needed
Main power supply
Bootloader (BOOT0)
