jenosek/BP/hardware/schematics/rf.kicad_sch

## KiCad design hardware/schematics/rf.kicad_sch (2025-04-11)

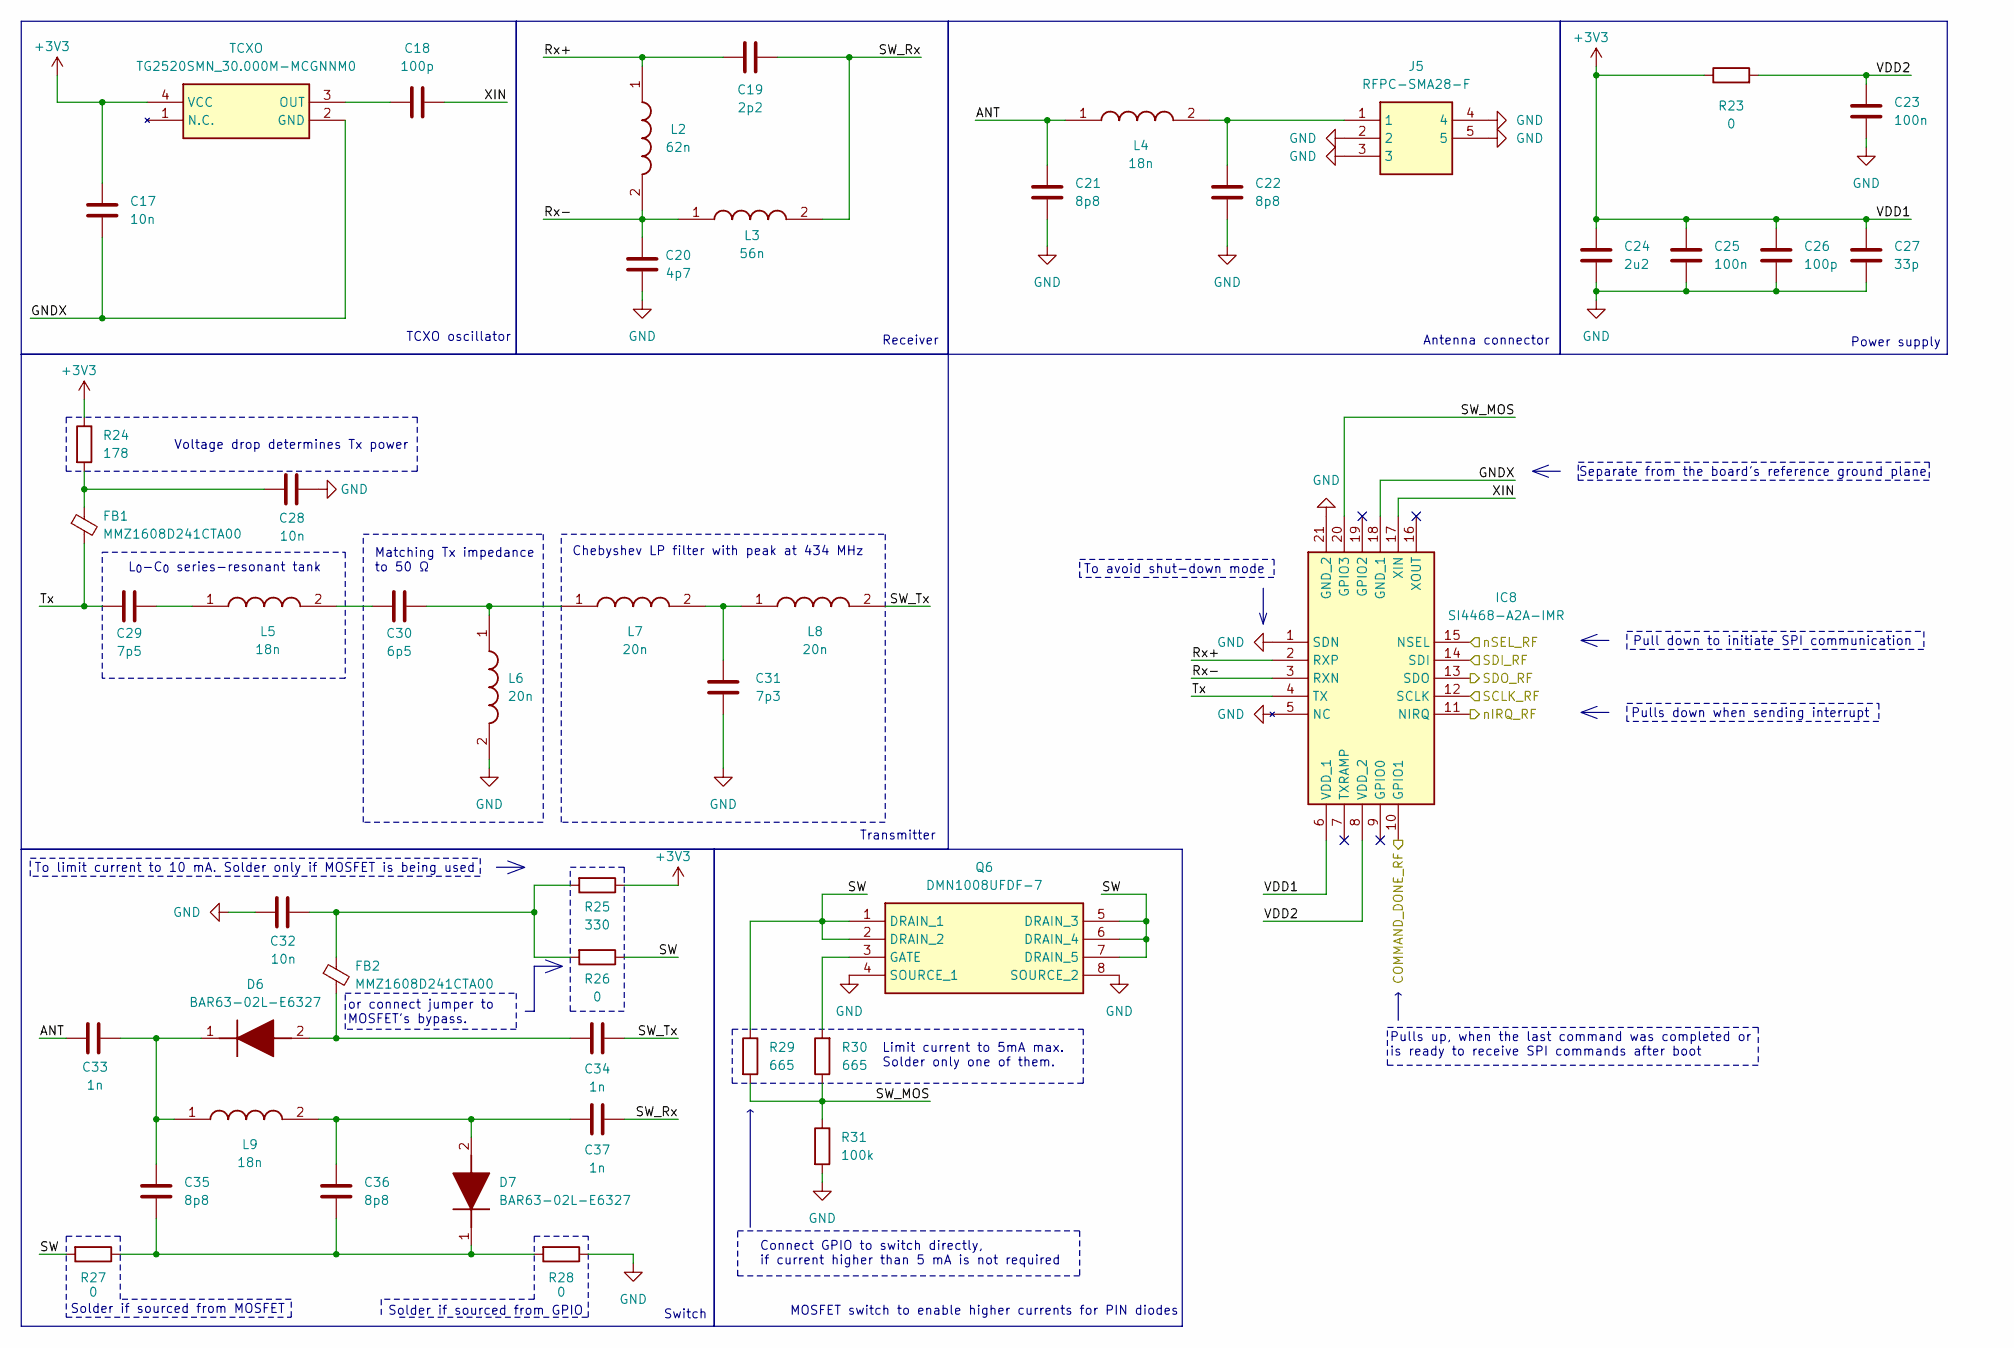
[picture p24: schematic rf.kicad_sch]

Parts:
C17, C28, C32: 10n; C_0402_1005Metric
C18: 100p; C_0402_1005Metric
C19: 2p2; C_0402_1005Metric
C20: 4p7; C_0402_1005Metric
C21, C22, C35, C36: 8p8; C_0402_1005Metric
C23: 100n; C_0402_1005Metric
C24: 2u2; C_0805_2012Metric
C25: 100n; C_0805_2012Metric
C26: 100p; C_0603_1608Metric
C27: 33p; C_0402_1005Metric
C29: 7p5; C_0402_1005Metric
C30: 6p5; C_0402_1005Metric
C31: 7p3
C33, C34, C37: 1n; C_0402_1005Metric
D6, D7: BAR63-02L-E6327; BAR6302LE6327; Manufacturer_Part_Number BAR63-02L-E6327
FB1, FB2: MMZ1608D241CTA00; BEADC1608X95N
IC8: SI4468-A2A-IMR; QFN50P400X400X90-21N; Manufacturer_Part_Number SI4468-A2A-IMR; Mouser Part Number 634-SI4468-A2A-IMR
J5: RFPC-SMA28-F; RFPCSMA28F; Manufacturer_Part_Number RFPC-SMA28-F; Mouser Part Number 640-RFPCSMA28F
L2: 62n; LQW15CNR20J00B; Manufacturer_Part_Number LQW15AN20NG00D; Mouser Part Number 81-LQW15AN20NG00D
L3: 56n; LQW15CNR20J00B; Manufacturer_Part_Number LQW15AN20NG00D; Mouser Part Number 81-LQW15AN20NG00D
L4, L5, L9: 18n; LQW15CNR20J00B; Manufacturer_Part_Number LQW15AN20NG00D; Mouser Part Number 81-LQW15AN20NG00D
L6, L7, L8: 20n; LQW15CNR20J00B; Manufacturer_Part_Number LQW15AN20NG00D; Mouser Part Number 81-LQW15AN20NG00D
Q6: DMN1008UFDF-7; DMN1008UFDF7; Manufacturer_Part_Number DMN1008UFDF-7; Mouser Part Number 621-DMN1008UFDF-7
R23, R26, R27, R28: 0; R_0603_1608Metric
R24: 178; R_0402_1005Metric
R25: 330; R_0603_1608Metric
R29, R30: 665; R_0402_1005Metric
R31: 100k; R_0402_1005Metric
TCXO: TG2520SMN_30.000M-MCGNNM0; TG2520SMN30000MMCGNNM0; Manufacturer_Part_Number TG2520SMN 30.000M-MCGNNM0; Mouser Part Number 732-2520SMN30MCGNNM0

Connections:
+3V3: C17.1, C24.1, C25.1, C26.1, C27.1, IC8.6 (VDD_1), R23.1, R24.1, R25.1, TCXO.4 (VCC)
ANT: C21.1, C33.1, L4.1
COMMAND_DONE_RF: IC8.10 (GPIO1)
GND: C20.1, C21.2, C22.2, C23.2, C24.2, C25.2, C26.2, C27.2, C28.1, C31.1, C32.2, IC8.1 (SDN), IC8.5 (NC), IC8.21 (GND_2), J5.2, J5.3, J5.4, J5.5, L6.2, Q6.4 (SOURCE_1), Q6.8 (SOURCE_2), R28.1, R31.2
GNDX: C17.2, IC8.18 (GND_1), TCXO.2 (GND)
unnamed: C18.1, TCXO.3 (OUT)
unnamed: C22.1, J5.1, L4.2
unnamed: C28.2, FB1.1, R24.2
unnamed: C29.2, L5.1
unnamed: C30.1, L5.2
unnamed: C30.2, L6.1, L7.1
unnamed: C31.2, L7.2, L8.1
unnamed: C32.1, FB2.1, R25.2, R26.2
unnamed: C33.2, C35.1, D6.1 (K), L9.1
unnamed: C34.1, D6.2 (A), FB2.2
unnamed: C35.2, C36.2, D7.1 (K), R27.1, R28.2
unnamed: C36.1, C37.1, D7.2 (A), L9.2
unnamed: Q6.3 (GATE), R30.2
Rx+: C19.1, IC8.2 (RXP), L2.1
Rx-: C20.2, IC8.3 (RXN), L2.2, L3.1
SCLK_RF: IC8.12 (SCLK)
SDI_RF: IC8.14 (SDI)
SDO_RF: IC8.13 (SDO)
SW: Q6.1 (DRAIN_1), Q6.2 (DRAIN_2), Q6.5 (DRAIN_3), Q6.6 (DRAIN_4), Q6.7 (DRAIN_5), R26.1, R27.2, R29.1
SW_MOS: IC8.20 (GPIO3), R29.2, R30.1, R31.1
SW_Rx: C19.2, C37.2, L3.2
SW_Tx: C34.2, L8.2
Tx: C29.1, FB1.2, IC8.4 (TX)
VDD2: C23.1, IC8.8 (VDD_2), R23.2
XIN: C18.2, IC8.17 (XIN)
nIRQ_RF: IC8.11 (NIRQ)
nSEL_RF: IC8.15 (NSEL)

Notes on the sheet:
Antenna connector
Receiver
Separate from the board's reference ground plane
Switch
Pulls up, when the last command was completed or is ready to receive SPI commands after boot
Solder if sourced from MOSFET
To limit current to 10 mA. Solder only if MOSFET is being used
Chebyshev LP filter with peak at 434 MHz
or connect jumper to MOSFET's bypass.
Solder if sourced from GPIO
Limit current to 5mA max. Solder only one of them.
Voltage drop determines Tx power
Pulls down when sending interrupt
Transmitter
To avoid shut-down mode
Pull down to initiate SPI communication
Connect GPIO to switch directly, if current higher than 5 mA is not required
Power supply
Matching Tx impedance to 50 Ω
MOSFET switch to enable higher currents for PIN diodes
TCXO oscillator
L_{0}-C_{0} series-resonant tank
