jenosek/BP/hardware/schematics/swd.kicad_sch

## KiCad design hardware/schematics/swd.kicad_sch (2025-03-06)

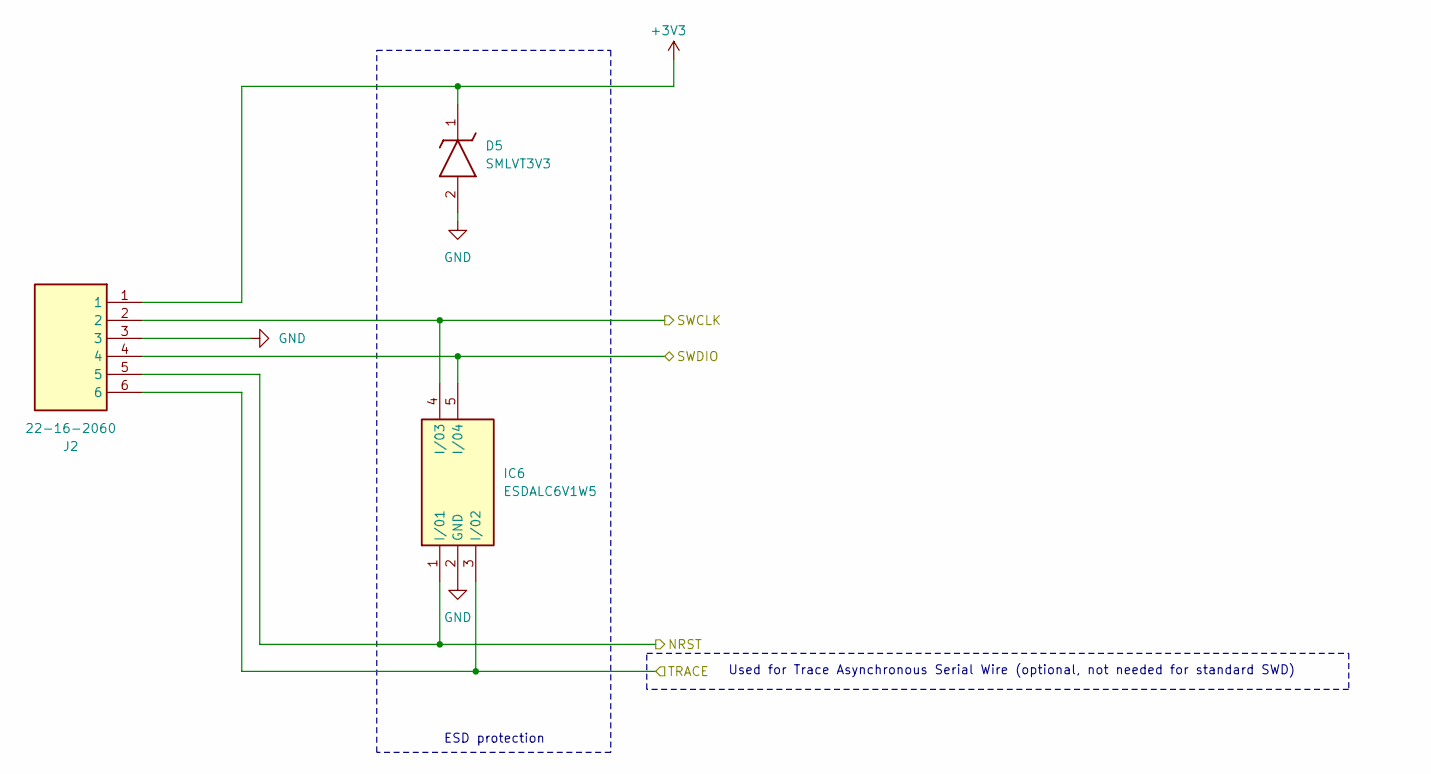
[picture p25: schematic swd.kicad_sch]

Parts:
D5: SMLVT3V3; DIOM5436X265N; Manufacturer_Part_Number SMLVT3V3; Mouser Part Number 511-SMLVT3V3
IC6: ESDALC6V1W5; SOT65P210X110-5N; Manufacturer_Part_Number ESDALC6V1W5; Mouser Part Number 511-ESDALC6V1W5
J2: 22-16-2060; 22162060; Manufacturer_Part_Number 22-16-2060; Mouser Part Number 538-22-16-2060

Connections:
+3V3: D5.1 (K), J2.1
GND: D5.2 (A), IC6.2 (GND), J2.3
NRST: IC6.1 (I/01), J2.5
SWCLK: IC6.4 (I/03), J2.2
SWDIO: IC6.5 (I/04), J2.4
TRACE: IC6.3 (I/02), J2.6

Notes on the sheet:
ESD protection
Used for Trace Asynchronous Serial Wire (optional, not needed for standard SWD)
