jenosek/BP/hardware/schematics/usb_b.kicad_sch

## KiCad design hardware/schematics/usb_b.kicad_sch (2025-03-09)

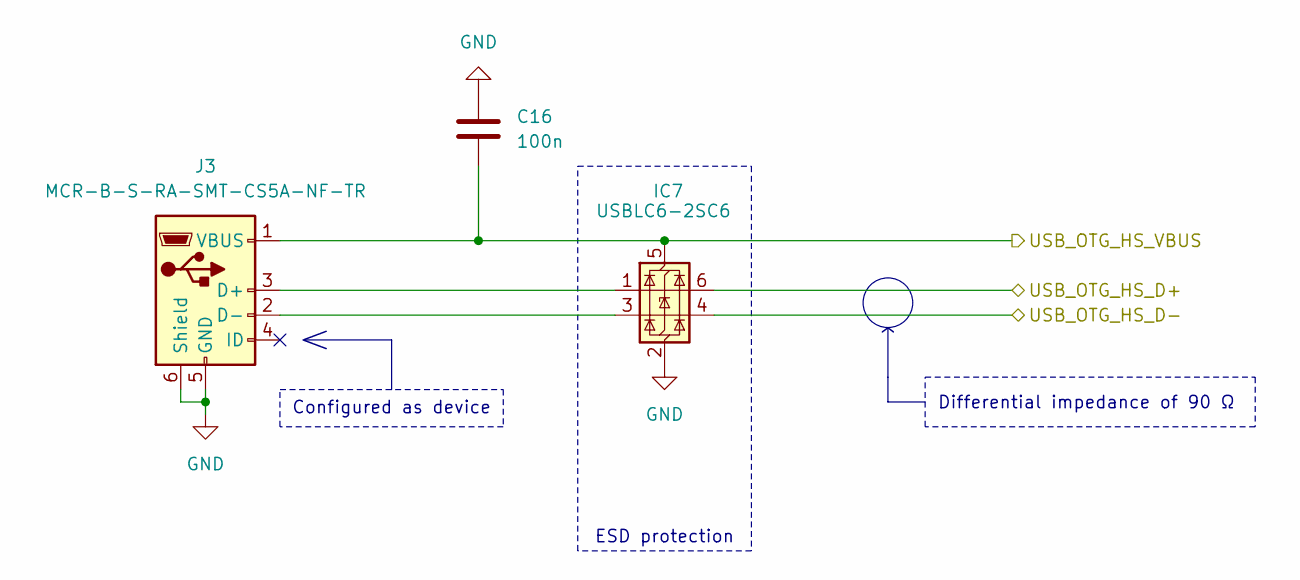
[picture p26: schematic usb_b.kicad_sch]

Parts:
C16: 100n; C_0402_1005Metric
IC7: USBLC6-2SC6; SOT-23-6
J3: MCR-B-S-RA-SMT-CS5A-NF-TR

Connections:
GND: C16.1, IC7.2 (GND), J3.5 (GND), J3.6 (Shield)
unnamed: IC7.1 (I/O1), J3.3 (D+)
unnamed: IC7.3 (I/O2), J3.2 (D-)
USB_OTG_HS_D+: IC7.6 (I/O1)
USB_OTG_HS_D-: IC7.4 (I/O2)
USB_OTG_HS_VBUS: C16.2, IC7.5 (VBUS), J3.1 (VBUS)

Notes on the sheet:
Differential impedance of 90 Ω
ESD protection
Configured as device
