jenosek/BP/hardware/schematics/usb_c.kicad_sch

## KiCad design hardware/schematics/usb_c.kicad_sch (2025-03-09)

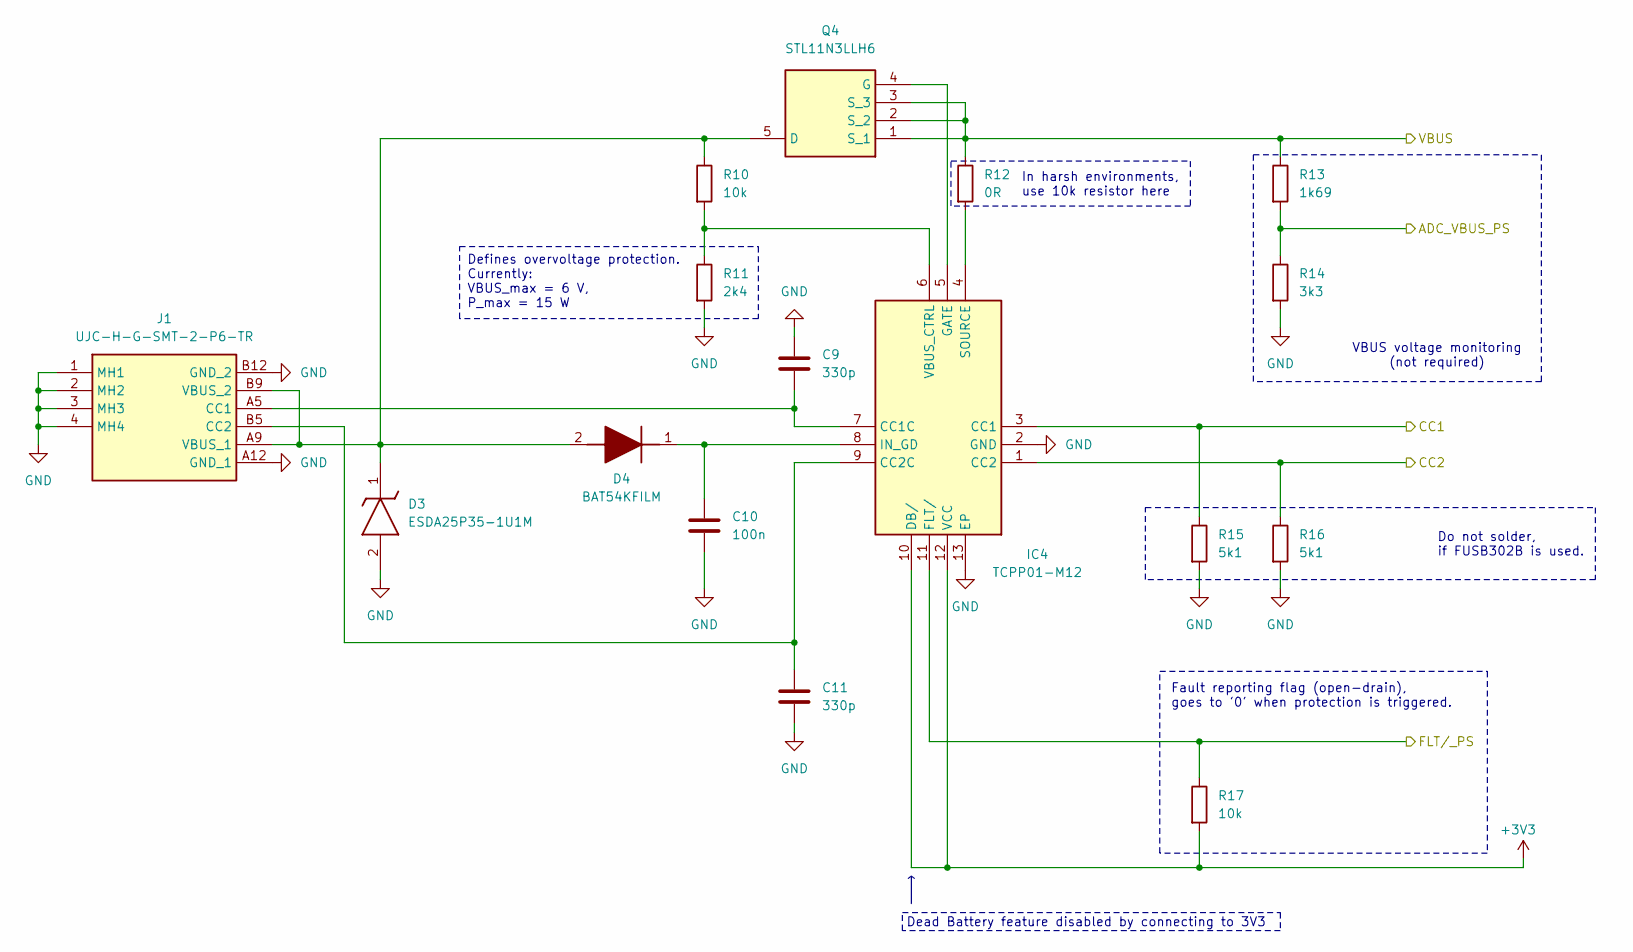
[picture p27: schematic usb_c.kicad_sch]

Parts:
C9, C11: 330p; C_0402_1005Metric
C10: 100n; C_0402_1005Metric
D3: ESDA25P35-1U1M; ESDA25P351U1M; Manufacturer_Part_Number ESDA25P35-1U1M; Mouser Part Number 511-ESDA25P35-1U1M
D4: BAT54KFILM; SODFL1608X70N; Manufacturer_Part_Number BAT54KFILM; Mouser Part Number 511-BAT54KFILM
IC4: TCPP01-M12; QFN50P300X300X100-13N-D; Manufacturer_Part_Number TCPP01-M12; Mouser Part Number 511-TCPP01-M12
J1: UJC-H-G-SMT-2-P6-TR; UJCHGSMT2P6TR; Manufacturer_Part_Number UJC-H-G-SMT-2-P6-TR; Mouser Part Number 179-UJCHGSMT2P6TR
Q4: STL11N3LLH6; STL20N6F7; Manufacturer_Part_Number STL11N3LLH6; Mouser Part Number 511-STL11N3LLH6
R10, R17: 10k; R_0402_1005Metric
R11: 2k4; R_0402_1005Metric
R12: 0R; R_0603_1608Metric
R13: 1k69; R_0402_1005Metric
R14: 3k3; R_0402_1005Metric
R15, R16: 5k1; R_0603_1608Metric

Connections:
+3V3: IC4.10 (DB/), IC4.12 (VCC), R17.2
ADC_VBUS_PS: R13.2, R14.1
CC1: IC4.3 (CC1), R15.1
CC2: IC4.1 (CC2), R16.1
FLT/_PS: IC4.11 (FLT/), R17.1
GND: C9.1, C10.2, C11.2, D3.2 (A), IC4.2 (GND), IC4.13 (EP), J1.1 (MH1), J1.2 (MH2), J1.3 (MH3), J1.4 (MH4), J1.A12 (GND_1), J1.B12 (GND_2), R11.2, R14.2, R15.2, R16.2
unnamed: C9.2, IC4.7 (CC1C), J1.A5 (CC1)
unnamed: C10.1, D4.1 (K), IC4.8 (IN_GD)
unnamed: C11.1, IC4.9 (CC2C), J1.B5 (CC2)
unnamed: D3.1 (K), D4.2 (A), J1.A9 (VBUS_1), J1.B9 (VBUS_2), Q4.5 (D), R10.1
unnamed: IC4.4 (SOURCE), R12.2
unnamed: IC4.5 (GATE), Q4.4 (G)
unnamed: IC4.6 (VBUS_CTRL), R10.2, R11.1
VBUS: Q4.1 (S_1), Q4.2 (S_2), Q4.3 (S_3), R12.1, R13.1

Notes on the sheet:
Dead Battery feature disabled by connecting to 3V3
VBUS voltage monitoring (not required)
Defines overvoltage protection. Currently: VBUS_max = 6 V, P_max = 15 W
In harsh environments, use 10k resistor here
Do not solder, if FUSB302B is used.
Fault reporting flag (open-drain), goes to '0' when protection is triggered.
