jenosek/BP/hardware/schematics/usb_interface.kicad_sch

## KiCad design hardware/schematics/usb_interface.kicad_sch (2025-04-11)

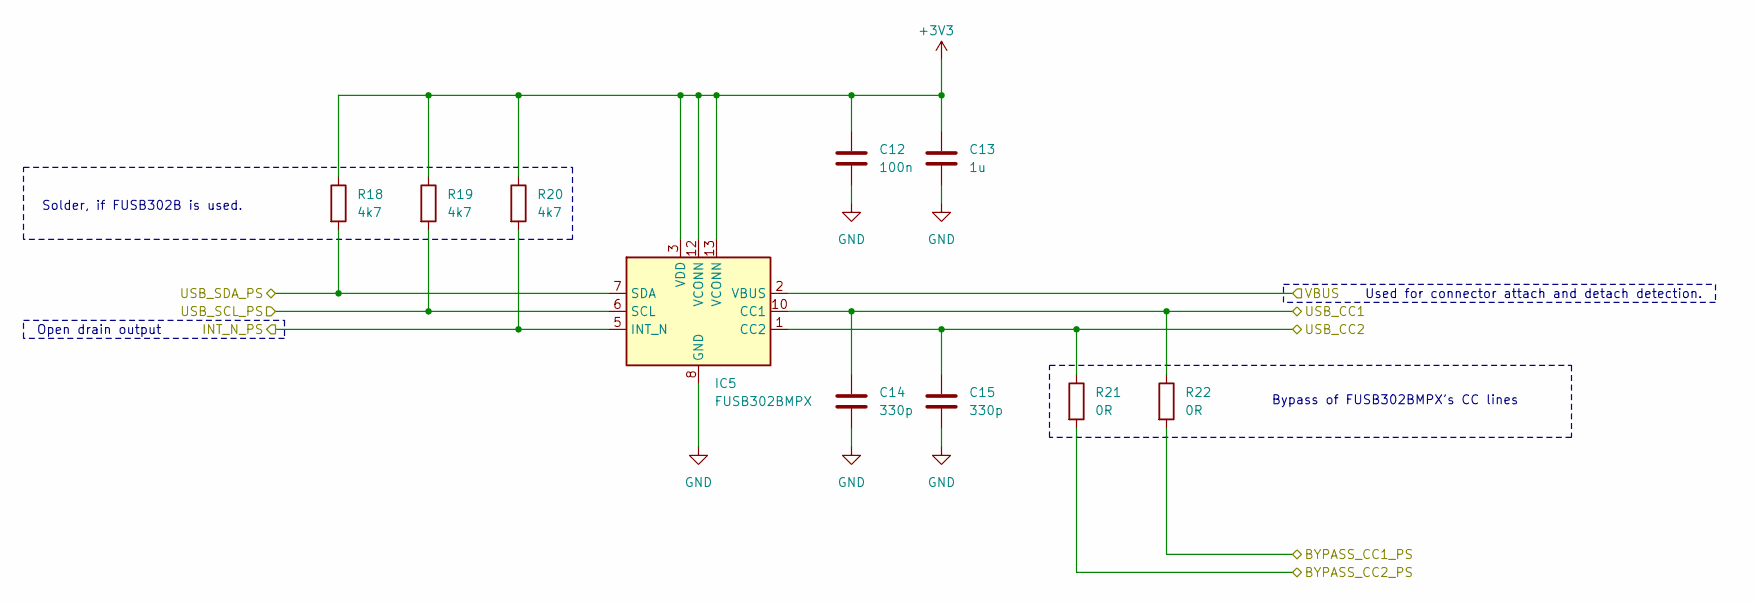
[picture p28: schematic usb_interface.kicad_sch]

Parts:
C12: 100n; C_0402_1005Metric
C13: 1u; C_0603_1608Metric
C14, C15: 330p; C_0402_1005Metric
IC5: FUSB302BMPX; WQFN-14-1EP_2.5x2.5mm_P0.5mm_EP1.45x1.45mm
R18, R19, R20: 4k7; R_0402_1005Metric
R21, R22: 0R; R_0603_1608Metric

Connections:
+3V3: C12.1, C13.1, IC5.3 (VDD), IC5.4 (VDD), IC5.12 (VCONN), IC5.13 (VCONN), R18.1, R19.1, R20.1
BYPASS_CC1_PS: R22.2
BYPASS_CC2_PS: R21.2
GND: C12.2, C13.2, C14.2, C15.2, IC5.8 (GND), IC5.9 (GND), IC5.15 (GND)
INT_N_PS: IC5.5 (INT_N), R20.2
USB_CC1: C14.1, IC5.10 (CC1), IC5.11 (CC1), R22.1
USB_CC2: C15.1, IC5.1 (CC2), IC5.14 (CC2), R21.1
USB_SCL_PS: IC5.6 (SCL), R19.2
USB_SDA_PS: IC5.7 (SDA), R18.2
VBUS: IC5.2 (VBUS)

Notes on the sheet:
Open drain output
Solder, if FUSB302B is used.
Bypass of FUSB302BMPX's CC lines
Used for connector attach and detach detection.
