jenosek/BP/software/thesis/Core/Src/main.c

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
/* Includes ------------------------------------------------------------------*/
#include "main.h"
#include "usb_device.h"

/* USER CODE BEGIN Includes */
#include "usbd_cdc_if.h"
/* USER CODE END Includes */

/* USER CODE BEGIN PTD */
#include "custom_typedefs.h"
/* USER CODE END PTD */

/* USER CODE BEGIN PD */
//#define GROUND_STATION									// <<<<<<< UNCOMMENT WHEN FLASHING THE GROUND STATION
/* USER CODE END PD */

ADC_HandleTypeDef hadc1;
ADC_HandleTypeDef hadc2;

DCMI_HandleTypeDef hdcmi;
DMA_HandleTypeDef hdma_dcmi;

I2C_HandleTypeDef hi2c2;

SPI_HandleTypeDef hspi4;
DMA_HandleTypeDef hdma_spi4_tx;
DMA_HandleTypeDef hdma_spi4_rx;

/* USER CODE BEGIN PV */
/* USER CODE BEGIN PV */
// Include of setup.h has to happen here, to support extern loading of globally defined variable

HAL_StatusTypeDef status = 0;
fault_flag error_index = 0;
char cmd_index = '0';
uint8_t cam_mode_select = 0xFF;
uint8_t radio_nirq = 0;
uint8_t ping_in_progress = 0;


uint32_t img_size;
uint8_t img_flag = 0; // img is not being transmitted
uint32_t img_progress = 0x100000000; // indicate actual position of transmitted img data - idle
uint8_t ack = 0;
#include <routines.h>
/* USER CODE END PV */

void SystemClock_Config(void);
void PeriphCommonClock_Config(void);
static void MPU_Config(void);
static void MX_GPIO_Init(void);
static void MX_DMA_Init(void);
static void MX_DCMI_Init(void);
static void MX_I2C2_Init(void);
static void MX_ADC1_Init(void);
static void MX_ADC2_Init(void);
static void MX_SPI4_Init(void);
/* USER CODE BEGIN 0 */

void USB_CDC_RxHandler(uint8_t *buffer, uint32_t size) {
	char cmd_temp = buffer[0];
	if (cmd_temp == '\r') {
		return;
	}
	else if (size == 1) {
		cmd_index = (char) buffer[0];
	}
	else {
		uint8_t first = (uint8_t) buffer[0] - '1';
		uint8_t second = (uint8_t) buffer[1] - '1';

		cam_mode_select = first * 16 + second;
		/*
		char mode_temp[2] = {buffer[0], buffer[1]};
		switch(mode_temp) {
			case "11": {cam_mode_select = 0x00;}
			case "12": {cam_mode_select = 0x01;}
			case "21": {cam_mode_select = 0x10;}
			case "22": {cam_mode_select = 0x11;}
			case "31": {cam_mode_select = 0x20;}
			case "32": {cam_mode_select = 0x21;}
			case "41": {cam_mode_select = 0x30;}
			case "42": {cam_mode_select = 0x31;}
			default: {
				cam_mode_select = 0xAA; //ERROR
			}
		}*/
	}
}

/* USER CODE END 0 */

/**
  * @brief  The application entry point.
  * @retval int
  */
int main(void)
{

  /* MPU Configuration--------------------------------------------------------*/
  MPU_Config();

  /* MCU Configuration--------------------------------------------------------*/

  /* Reset of all peripherals, Initializes the Flash interface and the Systick. */
  HAL_Init();

  /* Configure the system clock */
  SystemClock_Config();

  /* Configure the peripherals common clocks */
  PeriphCommonClock_Config();

  /* Initialize all configured peripherals */
  MX_GPIO_Init();
  MX_DMA_Init();
  MX_DCMI_Init();
  MX_I2C2_Init();
  MX_ADC1_Init();
  MX_ADC2_Init();
  MX_USB_DEVICE_Init();
  MX_SPI4_Init();
  /* Infinite loop */
  /* USER CODE BEGIN WHILE */

  setup(&status, &error_index);
  uint8_t img_buffer[614400] = {0};
  //nirq_handler(&status, &error_index, &ping_in_progress);
#ifdef GROUND_STATION
  cmd_main_win();
#endif
  //HAL_NVIC_EnableIRQ(nIRQ_EXTI_IRQn);
  while (1) {
 	  if (radio_nirq) {
		  // Handling of the packet IRQ
		  //HAL_NVIC_DisableIRQ(nIRQ_EXTI_IRQn);
		  nirq_handler(&status, &error_index, &ping_in_progress, &ack, img_buffer, &img_progress);
		  //HAL_NVIC_EnableIRQ(nIRQ_EXTI_IRQn);
		  radio_nirq = 0;
	  }
	  if (img_flag && ack) {
		  transmit_img(&status, &error_index, img_buffer, &img_progress);
		  ack = 0;

	  }
#ifdef GROUND_STATION
	  if (ping_in_progress == 2) {
		  ping_in_progress = 0;
		  uint8_t buffer[] = "Ping received \r\n";
		  uint8_t buffer_size = sizeof(buffer);
		  CDC_Transmit_HS(buffer, buffer_size);
	  }
	  switch (cmd_index) {

	  		  // Idle
	  		  case '0':
	  			break;

	  		  // Ping
	  		  case '1': {
	  			  ping_in_progress = 1;
	  			  radio_ping(&status);
	  			  uint8_t buffer[] = "Ping send \r\n";
	  			  uint8_t buffer_size = sizeof(buffer);
	  			  CDC_Transmit_HS(buffer, buffer_size);
	  			  cmd_index = '0';
	  			  break;
	  			}


	  		  // Telemetry
	  		  case '2': {
	  			  cmd_index = '0';
	  			break;
	  		  }

	  		  // IMG
	  		  case '3': {
	  			  cmd_img_options();
	  			  while (cam_mode_select == 0xFF) {
	  				  if (cam_mode_select == 0xAA) {
	  					  uint8_t buffer[] = "Unrecognized command \r\n";
	  					  uint16_t buffer_size = sizeof(buffer);
	  					  CDC_Transmit_HS(buffer, buffer_size);
	  					  cmd_index = '0';
	  					  break;
	  				  }
	  			  }
	  			  //capture_img(&status, &error_index, &cam_mode_select);
	  			  request_img(&status, &error_index, &cam_mode_select);
	  			  cmd_index = '0';
	  			  cam_mode_select = 0xFF; //return to default state
	  			break;
	  		  }
	  		  case '4': {
	  			uint8_t buffer[] = "\e[1;1H\e[2J";
	  			uint16_t buffer_size = sizeof(buffer);
	  			CDC_Transmit_HS(buffer, buffer_size);
	  			cmd_index = '0';
	  			HAL_Delay(100);
	  			cmd_main_win();
	  			break;
	  		  }
	  		  case '5': {
	  			  get_GS_state(&status);
	  			  cmd_index = '0';
	  			  break;
	  		  }
	  		  case '6': {
	  			img_flag = 0;
	  			cmd_index = '0';
	  			uint8_t buffer[] = "Flags reset \r\n";
	  			uint16_t buffer_size = sizeof(buffer);
	  			CDC_Transmit_HS(buffer, buffer_size);
	  			radio_mode_Rx(status);

	  			break;
	  		  }
	  		  default: {
	  			uint8_t buffer[] = "Unrecognized command \r\n";
	  			uint16_t buffer_size = sizeof(buffer);
	  			CDC_Transmit_HS(buffer, buffer_size);
	  			cmd_index = '0';
	  		  }
	  	  }
#endif

    /* USER CODE END WHILE */

    /* USER CODE BEGIN 3 */
  }
  /* USER CODE END 3 */
}

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
/* USER CODE BEGIN 4 */
void HAL_GPIO_EXTI_Callback(uint16_t GPIO_Pin)
{
  if(GPIO_Pin == GPIO_PIN_10) {
    radio_nirq = 1;
  }
}
/* USER CODE END 4 */

 /* MPU Configuration */

void MPU_Config(void)
{
  MPU_Region_InitTypeDef MPU_InitStruct = {0};

  /* Disables the MPU */
  HAL_MPU_Disable();

  /** Initializes and configures the Region and the memory to be protected
  */
  MPU_InitStruct.Enable = MPU_REGION_ENABLE;
  MPU_InitStruct.Number = MPU_REGION_NUMBER0;
  MPU_InitStruct.BaseAddress = 0x0;
  MPU_InitStruct.Size = MPU_REGION_SIZE_4GB;
  MPU_InitStruct.SubRegionDisable = 0x87;
  MPU_InitStruct.TypeExtField = MPU_TEX_LEVEL0;
  MPU_InitStruct.AccessPermission = MPU_REGION_NO_ACCESS;
  MPU_InitStruct.DisableExec = MPU_INSTRUCTION_ACCESS_DISABLE;
  MPU_InitStruct.IsShareable = MPU_ACCESS_SHAREABLE;
  MPU_InitStruct.IsCacheable = MPU_ACCESS_NOT_CACHEABLE;
  MPU_InitStruct.IsBufferable = MPU_ACCESS_NOT_BUFFERABLE;

  HAL_MPU_ConfigRegion(&MPU_InitStruct);
  /* Enables the MPU */
  HAL_MPU_Enable(MPU_PRIVILEGED_DEFAULT);

}

/**
  * @brief  This function is executed in case of error occurrence.
  * @retval None
  */
void Error_Handler(void)
{
  /* USER CODE BEGIN Error_Handler_Debug */
  /* User can add his own implementation to report the HAL error return state */
  __disable_irq();
  while (1)
  {
  }
  /* USER CODE END Error_Handler_Debug */
}

#ifdef  USE_FULL_ASSERT
/**
  * @brief  Reports the name of the source file and the source line number
  *         where the assert_param error has occurred.
  * @param  file: pointer to the source file name
  * @param  line: assert_param error line source number
  * @retval None
  */
void assert_failed(uint8_t *file, uint32_t line)
{
  /* USER CODE BEGIN 6 */
  /* User can add his own implementation to report the file name and line number,
     ex: printf("Wrong parameters value: file %s on line %d\r\n", file, line) */
  /* USER CODE END 6 */
}
#endif /* USE_FULL_ASSERT */
