jenosek/BP/software/thesis/thesis.ioc

Mcu.UserName=STM32H7A3VITx
PA0.GPIO_Label=NTC_2+
PA0.Signal=ADC1_INP16
PA1.GPIO_Label=NTC_2-
PA1.Signal=ADC1_INN16
PA11.Signal=USB_OTG_HS_DM
PA12.Signal=USB_OTG_HS_DP
PA13.Signal=DEBUG_JTMS-SWDIO
PA14.Signal=DEBUG_JTCK-SWCLK
PA4.Signal=DCMI_HSYNC
PA6.Signal=DCMI_PIXCLK
PA7.GPIO_Label=INT_N
PA7.Signal=GPIO_Input
PA8.GPIO_Label=DCMI_MCLK
PA8.Signal=RCC_MCO_1
PA9.Signal=USB_OTG_HS_VBUS
PB0.GPIO_Label=ADC_VBUS
PB0.Signal=ADCx_INP9
PB1.GPIO_Label=FLT/
PB1.Signal=GPIO_Input
PB10.Signal=I2C2_SCL
PB11.Signal=I2C2_SDA
PB12.GPIO_Label=SDN
PB12.Signal=GPIO_Output
PB3.Signal=DEBUG_JTDO-SWO
PB7.Signal=DCMI_VSYNC
PB8.Signal=DCMI_D6
PB9.Signal=DCMI_D7
PC11.Signal=DCMI_D4
PC4.GPIO_Label=CC1
PC4.Signal=ADCx_INP4
PC5.GPIO_Label=CC2
PC5.Signal=ADCx_INP8
PC6.Signal=DCMI_D0
PC7.Signal=DCMI_D1
PC8.Signal=DCMI_D2
PC9.Signal=DCMI_D3
PD10.GPIO_Label=DCMI_PWDN
PD10.Signal=GPIO_Output
PD3.Signal=DCMI_D5
PD9.GPIO_Label=DCMI_RST
PD9.Signal=GPIO_Output
PE10.GPIO_Label=nIRQ
PE10.Signal=GPXTI10
PE11.GPIO_Label=SPI4_nSEL
PE11.Signal=SPI4_NSS
PE12.Signal=SPI4_SCK
PE13.Signal=SPI4_MISO
PE14.Signal=SPI4_MOSI
PE15.GPIO_Label=DCMI_3V3
PE15.Signal=GPIO_Output
PE9.GPIO_Label=COMMAND_DONE
PE9.Signal=GPIO_Input
PH0-OSC_IN.Signal=RCC_OSC_IN
