jenosek/BP/software/thesis/Core/Src/ov7670.c

#include "ov7670.h"
/*
HAL_StatusTypeDef camera_write(uint8_t adress, uint8_t data) {
	HAL_StatusTypeDef status; //BUSY

	status = HAL_I2C_Mem_Write(p_I2C, CAM_WRITE, adress, I2C_MEMADD_SIZE_8BIT, &data, 1, 100);
	HAL_Delay(70);

	return status;
}

HAL_StatusTypeDef camera_read(uint8_t adress, uint8_t* data) {
	HAL_StatusTypeDef status;

	status = HAL_I2C_Master_Transmit(p_I2C, CAM_READ, &adress, 1, 100);
	status |= HAL_I2C_Master_Receive(p_I2C, CAM_READ, data, 1, 100);
	return status;
}
*/

void camera_init(HAL_StatusTypeDef* status, uint8_t* mode){

	//HAL_StatusTypeDef status;
	//uint8_t mode = resolution + format;
	//uint8_t read_value;



	// Power-up camera
	HAL_GPIO_WritePin(CAM_PWR_PORT, CAM_PWR_PIN, GPIO_PIN_SET);
	HAL_Delay(300);

	// Enable camera
	HAL_GPIO_WritePin(CAM_PWDN_PORT, CAM_PWDN_PIN, GPIO_PIN_RESET);
	HAL_Delay(300);

	// Reset camera
	HAL_GPIO_WritePin(CAM_RESET_PORT, CAM_RESET_PIN, GPIO_PIN_RESET);
	HAL_Delay(100);
	HAL_GPIO_WritePin(CAM_RESET_PORT, CAM_RESET_PIN, GPIO_PIN_SET);
	HAL_Delay(100);


	// Initialization common for all modes
	uint8_t data = 0x80;
	I2C_write(status, CAM_WRITE, CAM_COM7, &data);
	//status = camera_write(CAM_COM7, 0x80);			// Reset all registers
	I2C_read(status, CAM_WRITE, CAM_CLKRC, &data);
	data |= 0b1;
	I2C_write(status, CAM_WRITE, CAM_CLKRC, &data);
	//status |= camera_write(CAM_CLKRC, 0x01);		// Set clock pre-scaler /2, since A/C converter operates up to 12 MHz and input CLK is 24 MHz
	I2C_read(status, CAM_WRITE, CAM_DBLV, &data);
	data &= ~(1<<7 | 1<<6);
	//data = 0x0A;
	I2C_write(status, CAM_WRITE, CAM_DBLV, &data);
	//status |= camera_write(CAM_DBLV, 0x0A);			// Bypass PLL

	// Enable scaling for resolutions smaller than VGA
	if ((*mode != 0x00) && (*mode != 0x01)) {
		//status |= camera_write(CAM_COM3, 0x08);
		I2C_read(status, CAM_WRITE, CAM_COM3, &data);
		//data = 0x08;
		data |= 1<<3;
		I2C_write(status, CAM_WRITE, CAM_COM3, &data);
	}

	// Settings depending on choice of mode
	switch (*mode) {
	// VGA - YUV
	case 0x00: {
		//status |= camera_write(CAM_COM7, 0x00);		// Set output format
		data = 0x00;
		I2C_write(status, CAM_WRITE, CAM_COM7, &data);
		break;
	}
	// VGA - RGB565
	case 0x01: {
		//status |= camera_write(CAM_COM7, 0x04);		// Set output format
		data = 0x04;
		I2C_write(status, CAM_WRITE, CAM_COM7, &data);
		//status |= camera_write(CAM_COM15, 0xD0);	// Set 565 RGB option
		data = 0xD0;
		I2C_write(status, CAM_WRITE, CAM_COM15, &data);
		break;
	}
	// CIF - YUV
	case 0x10: {
		//status |= camera_write(CAM_COM7, 0x20);		// Set output format
		data = 0x20;
		I2C_write(status, CAM_WRITE, CAM_COM7, &data);
		break;
	}
	// CIF - RGB565
	case 0x11: {
		//status |= camera_write(CAM_COM7, 0x24);		// Set output format
		data = 0x24;
		I2C_write(status, CAM_WRITE, CAM_COM7, &data);
		//status |= camera_write(CAM_COM15, 0xD0);	// Set 565 RGB option
		data = 0xD0;
		I2C_write(status, CAM_WRITE, CAM_COM15, &data);
		break;
	}
	// QVGA - YUV
	case 0x20: {
		//status |= camera_write(CAM_COM7, 0x10);		// Set output format
		data = 0x10;
		I2C_write(status, CAM_WRITE, CAM_COM7, &data);
		break;
	}
	// QVGA - RGB565
	case 0x21: {
		//status |= camera_write(CAM_COM7, 0x14);		// Set output format
		data = 0x14;
		I2C_write(status, CAM_WRITE, CAM_COM7, &data);
		//status |= camera_write(CAM_COM15, 0xD0);	// Set 565 RGB option
		data = 0xD0;
		I2C_write(status, CAM_WRITE, CAM_COM15, &data);
		break;
	}
	// QCIF - YUV
	case 0x30: {
		//status |= camera_write(CAM_COM7, 0x08);		// Set output format
		data = 0x08;
		I2C_write(status, CAM_WRITE, CAM_COM7, &data);
		break;
	}
	// QCIF - RGB565
	case 0x31: {
		//status |= camera_write(CAM_COM7, 0x0C);		// Set output format
		I2C_read(status, CAM_WRITE, CAM_COM7, &data);
		//data = 0x0C;
		data |= (1 << 2);
		data &= ~(1);
		//data = 0x0C;
		I2C_write(status, CAM_WRITE, CAM_COM7, &data);
		//status |= camera_write(CAM_COM15, 0xD0);	// Set 565 RGB option
		//data = 0xD0;
		I2C_read(status, CAM_WRITE, CAM_COM15, &data);
		data &= ~(1<<5);
		data |= (1<<4);
		//data = 0xD0;
		I2C_write(status, CAM_WRITE, CAM_COM15, &data);
		break;
	}
	}


	//status |= camera_write(CAM_COM8, 0x8F);		// Automatic exposure & gain control
	//status |= camera_write(CAM_RSVD, 0x84);			// Colour correction
	data = 0x84;
	I2C_write(status, CAM_WRITE, CAM_RSVD, &data);

	//return status;
}


void camera_capture_photo(HAL_StatusTypeDef* status, uint8_t* destination_adress, uint32_t* size) {
	//HAL_StatusTypeDef status;

	// Begin transmission of data from camera to memory
	*status = HAL_DCMI_Start_DMA(&hdcmi, DCMI_MODE_SNAPSHOT, destination_adress, *size);
	HAL_Delay(5000);

	// End transmission
	*status |= HAL_DCMI_Stop(&hdcmi);

	//return status;
}

void camera_shut_down(HAL_StatusTypeDef* status) {
	//HAL_StatusTypeDef status;
	// Disable camera
	HAL_GPIO_WritePin(CAM_PWDN_PORT, CAM_PWDN_PIN, GPIO_PIN_RESET);
	HAL_Delay(300);

	// Power-down camera
	HAL_GPIO_WritePin(CAM_PWR_PORT, CAM_PWR_PIN, GPIO_PIN_RESET);
	HAL_Delay(300);

	//return status;
}
