jenosek/BP/(commit log)

2025-02-12 Structure changed
    [Charger-PowerManagement.kicad_sch, battery.kicad_sch, boot.kicad_sch, camera.kicad_sch, dc_dc.kicad_sch, grounds.kicad_sch, mcu.kicad_sch, obvod.kicad_pcb]
2025-02-15 USB-B micro added
    [mcu.kicad_sch, obvod.kicad_sch, usb_b.kicad_sch, usb_b_mini.kicad_sch, usb_interface.kicad_sch]
2025-02-16 MCU finished. Beginning RF
    [obvod.kicad_sch]
2025-02-24 RF_Tx matched to 50ohms
    [obvod.kicad_sch, rf.kicad_sch]
2025-02-27 RF switch design begun
    [rf.kicad_sch]
2025-02-27 Structure of repository changed
    [Charger-PowerManagement.kicad_sch, TX_PA.DSN, battery.kicad_sch, boot.kicad_sch, camera.kicad_sch, dc_dc.kicad_sch, grounds.kicad_sch, mcu.kicad_sch]
2025-02-28 Battery temperature meter added to MCU
    [Charger-PowerManagement.kicad_sch, LP_ANT.DSN, NTC.DSN, battery.kicad_sch, camera.kicad_sch, dc_dc.kicad_sch, lp_ant.opj, mcu.kicad_sch]
2025-03-01 0R added to RF supply
    [rf.kicad_sch, usb_interface.kicad_sch]
2025-03-03 Switch sim updated - final
    [top.sdf]
2025-03-03 Board connector added
    [Power_Management.kicad_sch, battery.kicad_sch, board_connector.kicad_sch, obvod.kicad_sch, rf.kicad_sch, usb_c.kicad_sch, usb_interface.kicad_sch]
2025-03-03 Fixed MOS and board connector
    [battery.kicad_sch, board_connector.kicad_sch, camera.kicad_sch, rf.kicad_sch]
2025-03-05 prevention save
    [Power_Management.kicad_sch, battery.kicad_sch, board_connector.kicad_sch, mcu.kicad_sch, obvod.kicad_sch]
2025-03-06 Revised and completed BOM
    [Power_Management.kicad_sch, battery.kicad_sch, board_connector.kicad_sch, camera.kicad_sch, dc_dc.kicad_sch, mcu.kicad_sch, obvod.kicad_sch, rf.kicad_sch]
2025-03-07 Added symbol/model lib to files
    [Charger-PowerManagement.kicad_sch, Power_Management.kicad_sch, battery.kicad_sch, board_connector.kicad_sch, boot.kicad_sch, camera.kicad_sch, dc_dc.kicad_sch, grounds.kicad_sch]
2025-03-07 EPS board started
    [boot.kicad_sch, eps.kicad_pcb, eps.kicad_sch, grounds.kicad_sch, test.kicad_sch, untitled.kicad_sch, usb_b_mini.kicad_sch]
2025-03-07 Device change compability fixed
2025-03-09 EPS board created
    [Power_Management.kicad_sch, eps.kicad_pcb, eps.kicad_sch, mcu.kicad_sch, rf.kicad_sch, usb_b.kicad_sch, usb_c.kicad_sch, usb_interface.kicad_sch]
2025-03-12 Draft of EPS PCB half-way done
    [eps.kicad_pcb, eps.kicad_sch]
2025-03-13 EPS pcb layout v0.1
    [eps.kicad_pcb]
2025-03-16 PCB-EPS 1/2
    [eps.kicad_pcb, eps.kicad_sch, tx_pa.opj]
2025-03-16 EPS-PCB gnd fill reamaining
    [eps.kicad_pcb, top.sdf]
2025-03-20 PCB - EPS done. RF started
    [eps.kicad_pcb, eps.kicad_sch, rf.kicad_pcb, rf.kicad_sch]
2025-03-21 RF finished
    [eps.kicad_pcb, rf.kicad_pcb]
2025-03-23 PCB - RF done, 1/2 MCU
    [mcu.kicad_pcb, mcu.kicad_sch, rf.kicad_pcb]
2025-03-23 ESP additional save
    [eps.kicad_pcb]
2025-03-27 Done? Rev.:1.2
    [eps.kicad_pcb, mcu.kicad_pcb, mcu.kicad_sch, rf.kicad_pcb]
2025-04-11 gitignore added
    [eps-B_Cu.gbr, eps-B_Mask.gbr, eps-B_Silkscreen.gbr, eps-Edge_Cuts.gbr, eps-F_Cu.gbr, eps-F_Mask.gbr, eps-F_Paste.gbr, eps-F_Silkscreen.gbr]
2025-04-11 ant. smooth corners
    [antenna.kicad_pcb, antenna.kicad_sch]
2025-04-19 Ant done
    [antenna.kicad_pcb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]
2025-05-11 preventive save - SPI halfway done
    [lp_ant.opj, tx_pa.opj]
2025-05-24 working on SPI opt.
2025-05-26 RF SPI working
2025-05-31 Matlab added
    [lp_ant.opj, rf.kicad_sch, tx_pa.opj]
